filipesbp/hellen88m42bmw/boards/hellen88m42bmw-d/board/hellen88m42bmw-d.png

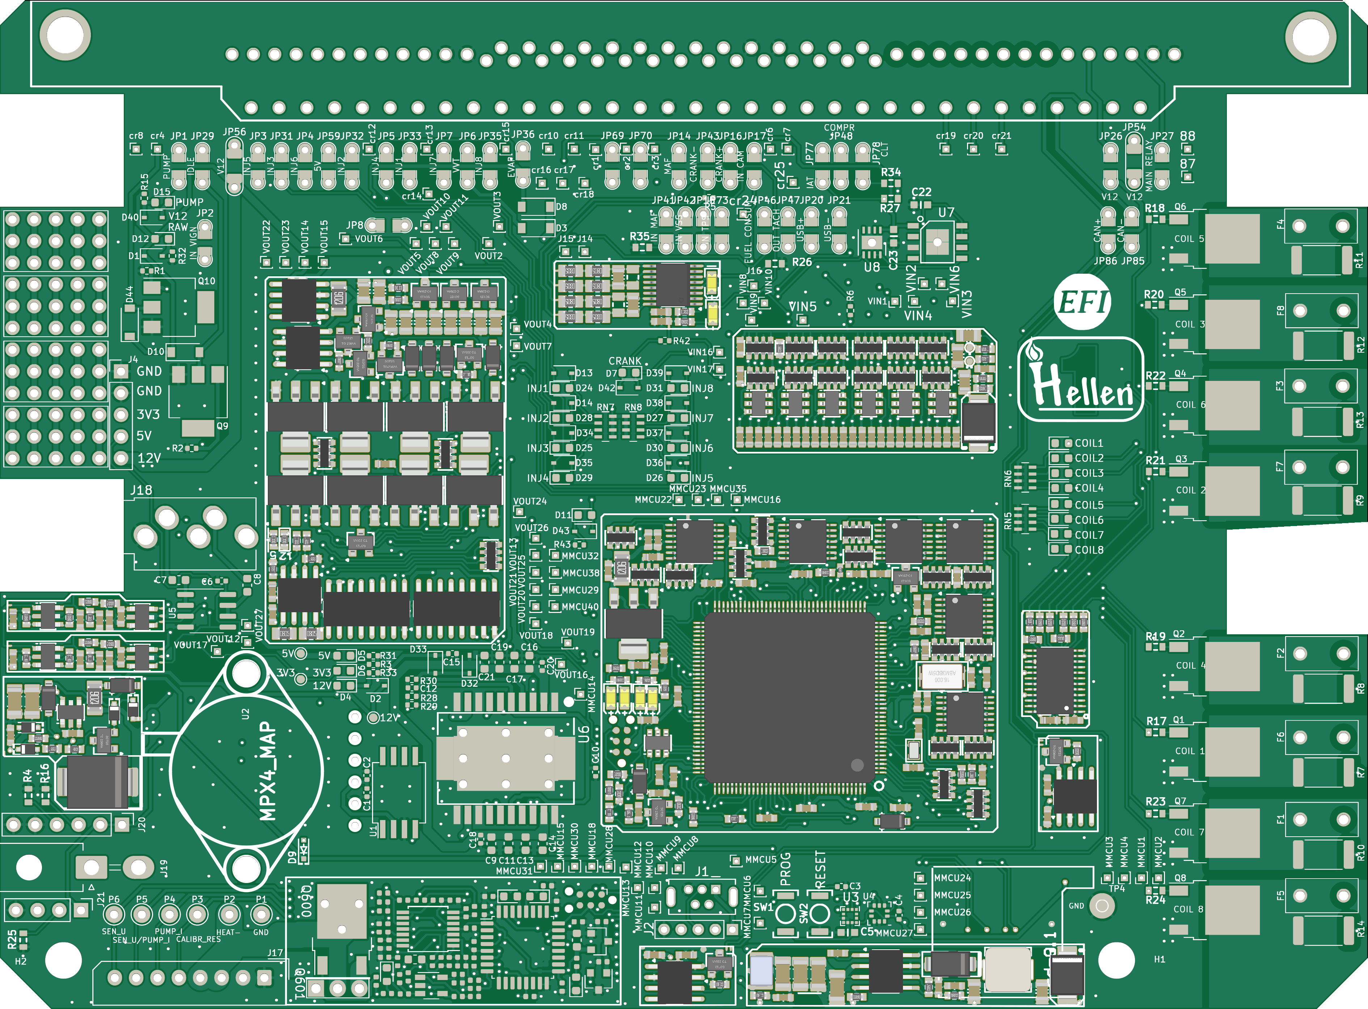
boards/hellen88m42bmw-d/board/hellen88m42bmw-d.png
