filipesbp/hellen88m42bmw/boards/hellen88m42bmw-d/board/misc/hellen88m42bmw-d-outline.png

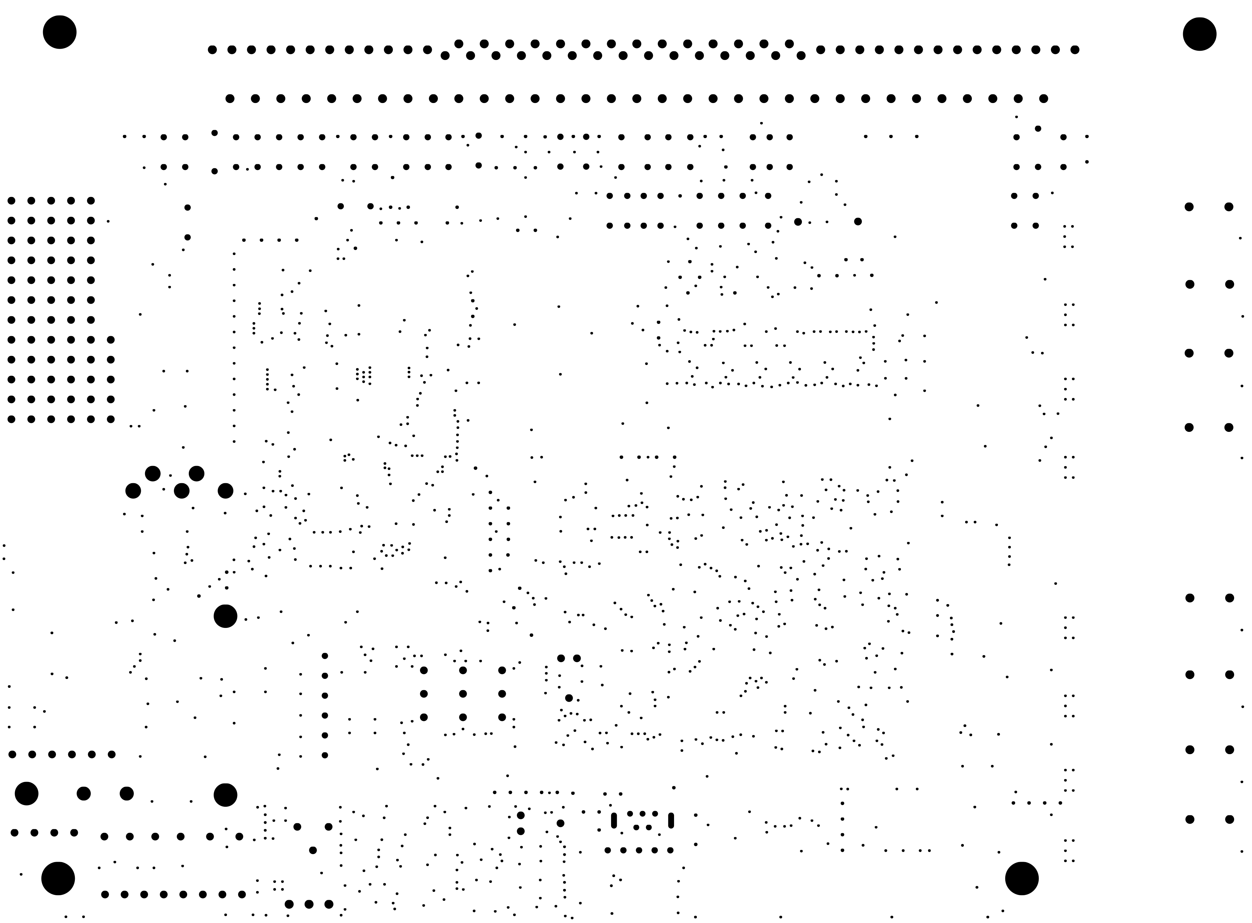
boards/hellen88m42bmw-d/board/misc/hellen88m42bmw-d-outline.png
