filipesbp/hellen88m42bmw/boards/hellen88m42bmw-d/board/misc/hellen88m42bmw-d-top.png

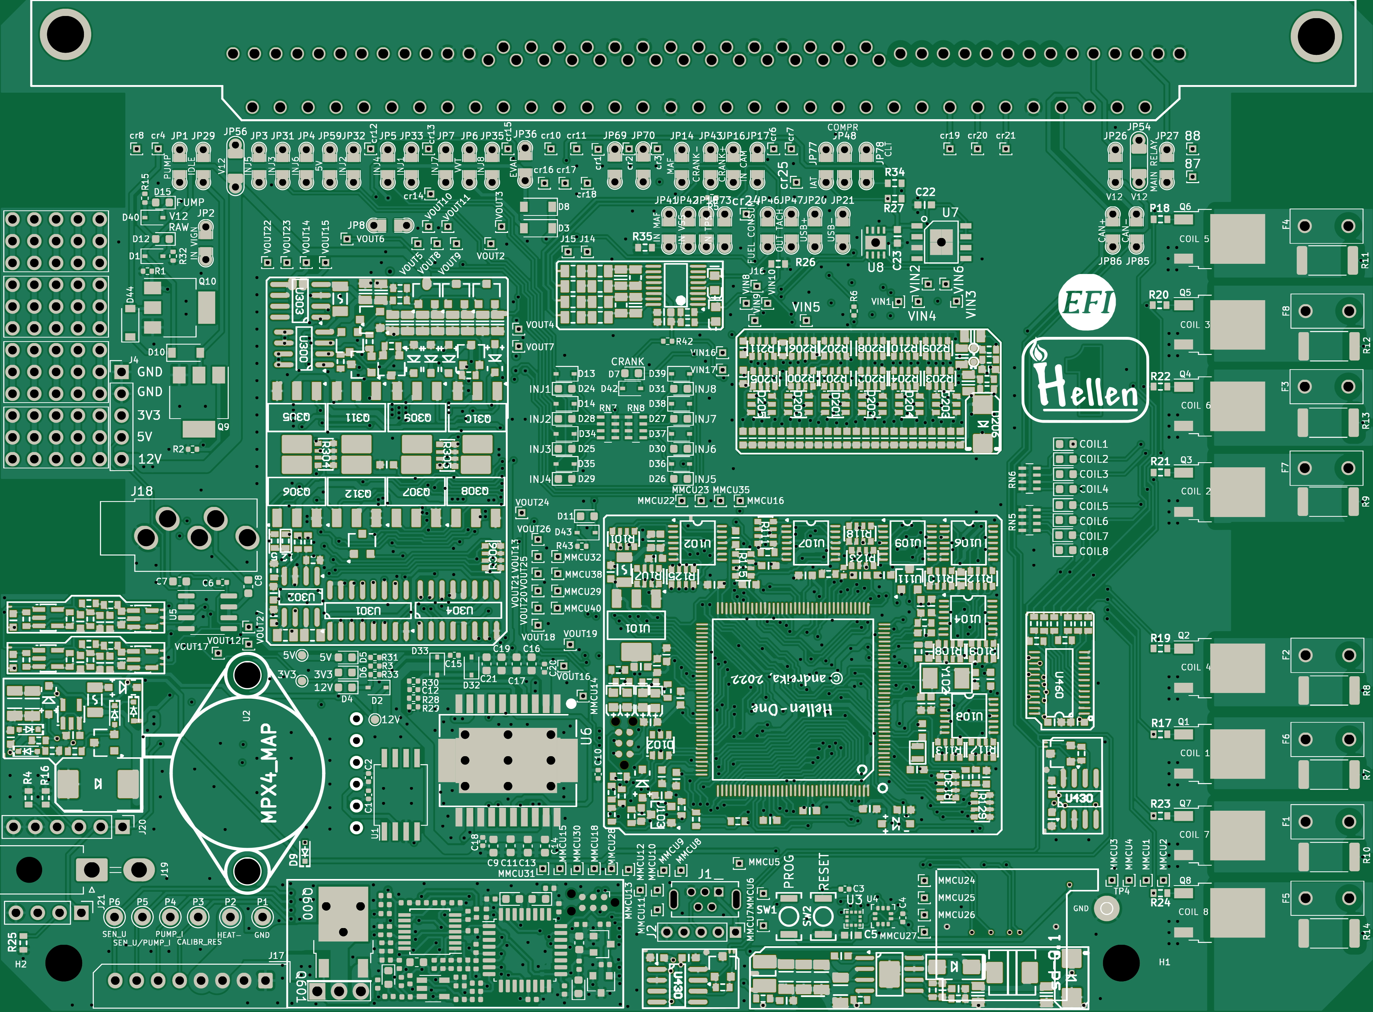
boards/hellen88m42bmw-d/board/misc/hellen88m42bmw-d-top.png
