filipesbp/hellen88m42bmw/gerber/hellen88m42bmw.csv

Comment | Designator | Footprint | LCSC Part #
BATTERY_CR2032 | BT1 | Battery:BatteryHolder_Keystone_1060_1x2032 | C70377
100nF | C1 | Capacitor_SMD:C_0402_1005Metric | C307331
100nF | C2 | Capacitor_SMD:C_0402_1005Metric | C307331
100nF | C3 | Capacitor_SMD:C_0402_1005Metric | C307331
100nF | C4 | Capacitor_SMD:C_0402_1005Metric | C307331
100n | C5 | hellen-one-common:C0603 | C14663
100nF | C6 | Capacitor_SMD:C_0402_1005Metric | C307331
10u | C7 | Capacitor_SMD:C_0603_1608Metric | C96446
10u | C8 | Capacitor_SMD:C_0603_1608Metric | C96446
10u | C9 | Capacitor_SMD:C_0603_1608Metric | C96446
5.6nF | C10 | Capacitor_SMD:C_0402_1005Metric | C115688
10u | C11 | Capacitor_SMD:C_0603_1608Metric | C96446
10nF | C12 | Capacitor_SMD:C_0402_1005Metric | C15195
10u | C13 | Capacitor_SMD:C_0603_1608Metric | C96446
10u | C14 | Capacitor_SMD:C_0603_1608Metric | C96446
220nF | C15 | Capacitor_SMD:C_0402_1005Metric | C16772
10u | C16 | Capacitor_SMD:C_0603_1608Metric | C96446
10u | C17 | Capacitor_SMD:C_0603_1608Metric | C96446
100nF | C18 | Capacitor_SMD:C_0402_1005Metric | C307331
10u | C19 | Capacitor_SMD:C_0603_1608Metric | C96446
100nF | C20 | Capacitor_SMD:C_0402_1005Metric | C307331
10u | C21 | Capacitor_SMD:C_0603_1608Metric | C96446
1u | C22 | hellen-one-common:C0603 | C15849
1u | C23 | hellen-one-common:C0603 | C15849
cr | cr1 | Connector_PinHeader_1.00mm:PinHeader_1x01_P1.00mm_Vertical
cr | cr2 | Connector_PinHeader_1.00mm:PinHeader_1x01_P1.00mm_Vertical
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
MMCU | MMCU31 | Connector_PinHeader_1.00mm:PinHeader_1x01_P1.00mm_Vertical
MMCU | MMCU32 | Connector_PinHeader_1.00mm:PinHeader_1x01_P1.00mm_Vertical
MMCU | MMCU35 | Connector_PinHeader_1.00mm:PinHeader_1x01_P1.00mm_Vertical
MMCU | MMCU38 | Connector_PinHeader_1.00mm:PinHeader_1x01_P1.00mm_Vertical
MMCU | MMCU40 | Connector_PinHeader_1.00mm:PinHeader_1x01_P1.00mm_Vertical
P | P1 | Connector_Pin:Pin_D1.0mm_L10.0mm
P | P2 | Connector_Pin:Pin_D1.0mm_L10.0mm
P | P3 | Connector_Pin:Pin_D1.0mm_L10.0mm
P | P4 | Connector_Pin:Pin_D1.0mm_L10.0mm
P | P5 | Connector_Pin:Pin_D1.0mm_L10.0mm
P | P6 | Connector_Pin:Pin_D1.0mm_L10.0mm
Motronic_88pin | PP1 | rusefi_lib_private:88pin_STS
NGD8201AN | Q1 | Package_TO_SOT_SMD:TO-252-2 | C151649
NGD8201AN | Q2 | Package_TO_SOT_SMD:TO-252-2 | C151649
NGD8201AN | Q3 | Package_TO_SOT_SMD:TO-252-2 | C151649
NGD8201AN | Q4 | Package_TO_SOT_SMD:TO-252-2 | C151649
NGD8201AN | Q5 | Package_TO_SOT_SMD:TO-252-2 | C151649
NGD8201AN | Q6 | Package_TO_SOT_SMD:TO-252-2 | C151649
NGD8201AN | Q7 | Package_TO_SOT_SMD:TO-252-2 | C151649
NGD8201AN | Q8 | Package_TO_SOT_SMD:TO-252-2 | C151649
AUIPS2041LTR | Q9 | Package_TO_SOT_SMD:SOT-223 | C113610
AUIPS2041LTR | Q10 | Package_TO_SOT_SMD:SOT-223 | C113610
10k | R1 | Resistor_SMD:R_0402_1005Metric | C60489
10k | R2 | Resistor_SMD:R_0402_1005Metric | C60489
750R | R3 | Resistor_SMD:R_0402_1005Metric | C25132
680k | R4 | hellen-one-common:R0603 | C25822
DNP | R5 | Resistor_SMD:R_0402_1005Metric
DNP | R6 | Resistor_SMD:R_0402_1005Metric
DNP | R7 | Resistor_SMD:R_2512_6332Metric | NA
DNP | R8 | Resistor_SMD:R_2512_6332Metric | NA
DNP | R9 | Resistor_SMD:R_2512_6332Metric | NA
DNP | R10 | Resistor_SMD:R_2512_6332Metric | NA
DNP | R11 | Resistor_SMD:R_2512_6332Metric | NA
DNP | R12 | Resistor_SMD:R_2512_6332Metric | NA
DNP | R13 | Resistor_SMD:R_2512_6332Metric | NA
DNP | R14 | Resistor_SMD:R_2512_6332Metric | NA
20k | R15 | Resistor_SMD:R_0402_1005Metric | C25765
680k | R16 | hellen-one-common:R0603 | C25822
22 | R17 | hellen-one-common:R0603 | C23345
22 | R18 | hellen-one-common:R0603 | C23345
22 | R19 | hellen-one-common:R0603 | C23345
22 | R20 | hellen-one-common:R0603 | C23345
22 | R21 | hellen-one-common:R0603 | C23345
22 | R22 | hellen-one-common:R0603 | C23345
22 | R23 | hellen-one-common:R0603 | C23345
22 | R24 | hellen-one-common:R0603 | C23345
680k | R25 | hellen-one-common:R0603 | C25822
DNP | R26 | hellen-one-common:R0603
2.7k | R27 | hellen-one-common:R0603 | C13167
100k | R28 | Resistor_SMD:R_0402_1005Metric | C106234
10k | R29 | Resistor_SMD:R_0402_1005Metric | C60489
100 | R30 | Resistor_SMD:R_0402_1005Metric | C106233
1k6 | R31 | Resistor_SMD:R_0402_1005Metric | C25931
5k1 | R32 | Resistor_SMD:R_0402_1005Metric | C25941
5k1 | R33 | Resistor_SMD:R_0402_1005Metric | C25941
2.7k | R34 | hellen-one-common:R0603 | C13167
DNP | R35 | hellen-one-common:R0603
4.7k | R42 | Resistor_SMD:R_0402_1005Metric | C25940
5k1 | R43 | Resistor_SMD:R_0402_1005Metric | C25941
1k | RN5 | Resistor_SMD:R_Array_Concave_4x0603 | C240722
1k | RN6 | Resistor_SMD:R_Array_Concave_4x0603 | C240722
4.7k | RN7 | Resistor_SMD:R_Array_Concave_4x0603 | C1980
4.7k | RN8 | Resistor_SMD:R_Array_Concave_4x0603 | C1980
Button_SPST | SW1 | hellen-one-common:SMD-2_2.9x3.9x1.7 | C115357
Button_SPST | SW2 | hellen-one-common:SMD-2_2.9x3.9x1.7 | C115357
TestPoint | TP1 | TestPoint:TestPoint_Pad_D1.0mm
TestPoint | TP2 | TestPoint:TestPoint_Pad_D1.0mm
TestPoint | TP3 | TestPoint:TestPoint_Pad_D1.0mm
TestPoint | TP4 | TestPoint:TestPoint_Pad_D1.0mm
MPXA6115A | U1 | Package_SO:SSO-8_6.8x5.9mm_P1.27mm_Clearance7mm
MPX4_MAP | U2 | rusefi_lib:MPX-4_MAP
LIS2DW12TR | U3 | hellen-one-common:LGA-12_2x2mm_P0.5mm | C189624
LPS25HB | U4 | Package_LGA:ST_HLGA-10_2.5x2.5mm_P0.6mm_LayoutBorder3x2y | C87898
MCP6002-xSN | U5 | Package_SO:SOIC-8_3.9x4.9mm_P1.27mm | C7377
L6205PD | U6 | hellen-one-common:SO20POWER | C36543
TLS115_SOIC | U7 | hellen-one-common:PG-DSO-8-43 | C540242
TLS115_SON | U8 | Package_SON:HVSON-8-1EP_3x3mm_P0.65mm_EP1.6x2.4mm
VIN8 | VIN1 | Connector_PinHeader_1.00mm:PinHeader_1x01_P1.00mm_Vertical
VIN8 | VIN2 | Connector_PinHeader_1.00mm:PinHeader_1x01_P1.00mm_Vertical
VIN8 | VIN3 | Connector_PinHeader_1.00mm:PinHeader_1x01_P1.00mm_Vertical
VIN8 | VIN4 | Connector_PinHeader_1.00mm:PinHeader_1x01_P1.00mm_Vertical
VIN8 | VIN5 | Connector_PinHeader_1.00mm:PinHeader_1x01_P1.00mm_Vertical
VIN8 | VIN6 | Connector_PinHeader_1.00mm:PinHeader_1x01_P1.00mm_Vertical
VIN8 | VIN8 | Connector_PinHeader_1.00mm:PinHeader_1x01_P1.00mm_Vertical
VIN9 | VIN9 | Connector_PinHeader_1.00mm:PinHeader_1x01_P1.00mm_Vertical
VIN10 | VIN10 | Connector_PinHeader_1.00mm:PinHeader_1x01_P1.00mm_Vertical
VIN16 | VIN16 | Connector_PinHeader_1.00mm:PinHeader_1x01_P1.00mm_Vertical
VIN17 | VIN17 | Connector_PinHeader_1.00mm:PinHeader_1x01_P1.00mm_Vertical
VOUT4 | VOUT2 | Connector_PinHeader_1.00mm:PinHeader_1x01_P1.00mm_Vertical
VOUT4 | VOUT3 | Connector_PinHeader_1.00mm:PinHeader_1x01_P1.00mm_Vertical
VOUT4 | VOUT4 | Connector_PinHeader_1.00mm:PinHeader_1x01_P1.00mm_Vertical
VOUT5 | VOUT5 | Connector_PinHeader_1.00mm:PinHeader_1x01_P1.00mm_Vertical
VOUT6 | VOUT6 | Connector_PinHeader_1.00mm:PinHeader_1x01_P1.00mm_Vertical
VOUT4 | VOUT7 | Connector_PinHeader_1.00mm:PinHeader_1x01_P1.00mm_Vertical
VOUT4 | VOUT8 | Connector_PinHeader_1.00mm:PinHeader_1x01_P1.00mm_Vertical
VOUT4 | VOUT9 | Connector_PinHeader_1.00mm:PinHeader_1x01_P1.00mm_Vertical
VOUT4 | VOUT10 | Connector_PinHeader_1.00mm:PinHeader_1x01_P1.00mm_Vertical
VOUT4 | VOUT11 | Connector_PinHeader_1.00mm:PinHeader_1x01_P1.00mm_Vertical
VOUT4 | VOUT12 | Connector_PinHeader_1.00mm:PinHeader_1x01_P1.00mm_Vertical
VOUT4 | VOUT13 | Connector_PinHeader_1.00mm:PinHeader_1x01_P1.00mm_Vertical
VOUT4 | VOUT14 | Connector_PinHeader_1.00mm:PinHeader_1x01_P1.00mm_Vertical
VOUT4 | VOUT15 | Connector_PinHeader_1.00mm:PinHeader_1x01_P1.00mm_Vertical
VOUT4 | VOUT16 | Connector_PinHeader_1.00mm:PinHeader_1x01_P1.00mm_Vertical
VOUT4 | VOUT17 | Connector_PinHeader_1.00mm:PinHeader_1x01_P1.00mm_Vertical
VOUT4 | VOUT18 | Connector_PinHeader_1.00mm:PinHeader_1x01_P1.00mm_Vertical
VOUT4 | VOUT19 | Connector_PinHeader_1.00mm:PinHeader_1x01_P1.00mm_Vertical
VOUT4 | VOUT20 | Connector_PinHeader_1.00mm:PinHeader_1x01_P1.00mm_Vertical
VOUT4 | VOUT21 | Connector_PinHeader_1.00mm:PinHeader_1x01_P1.00mm_Vertical
VOUT4 | VOUT22 | Connector_PinHeader_1.00mm:PinHeader_1x01_P1.00mm_Vertical
VOUT4 | VOUT23 | Connector_PinHeader_1.00mm:PinHeader_1x01_P1.00mm_Vertical
VOUT4 | VOUT24 | Connector_PinHeader_1.00mm:PinHeader_1x01_P1.00mm_Vertical
VOUT4 | VOUT25 | Connector_PinHeader_1.00mm:PinHeader_1x01_P1.00mm_Vertical
VOUT4 | VOUT26 | Connector_PinHeader_1.00mm:PinHeader_1x01_P1.00mm_Vertical
VOUT4 | VOUT27 | Connector_PinHeader_1.00mm:PinHeader_1x01_P1.00mm_Vertical
