filipesbp/hellen88m42bmw/boards/hellen88m42bmw-d/frame/88m42bmw-schematic.pdf

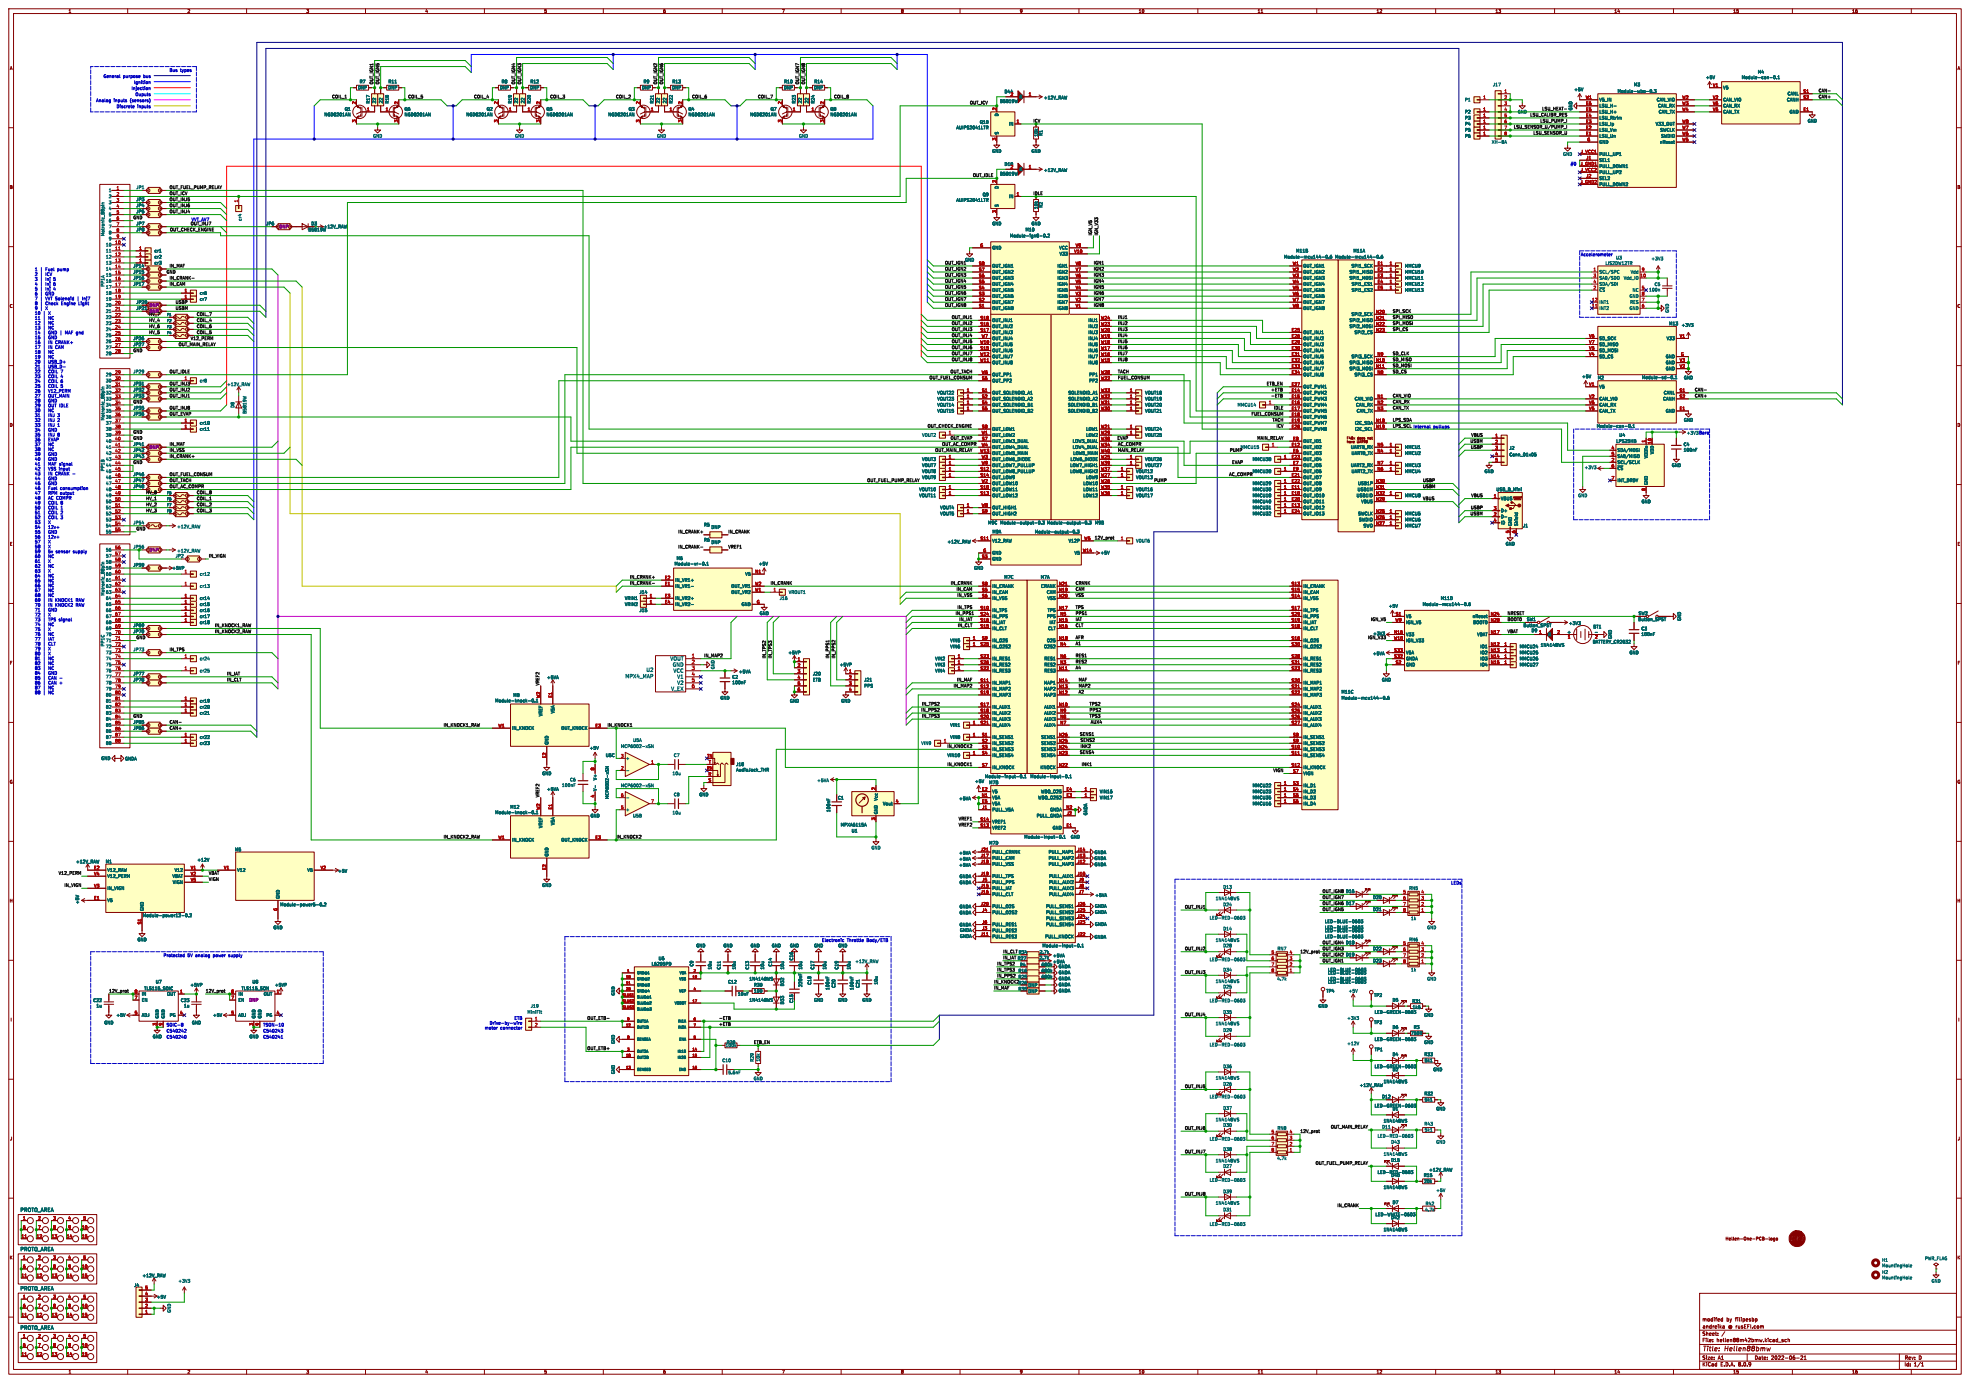
[picture p5: page 1]

39 | GND
40 | GND
41 | MAF signal 42 | VSS input 43 | IN CRANK - 44 | GND

45 | GND
46 | Fuel consumption
47 | RPM output 48 | AC COMPR

S11 GND
V12_RAW
N19 VSS N20 CRANK N21 KNOCK N22 SENS4 N23 SENS3 N24 SENS2 N25 SENS1 N26 RES2 N3 O2S2 N4 PPS N5 RES1 N6 AUX4 N7 AUX3 N8 AUX2 N9 M7A Module-input-0.1 GND

IAT N15 CLT N16 TPS N17 O2S N18 CAM

8 GND M12 Module-knock-0.1 V5A E1 GND E2 OUT_KNOCK E3 IN_KNOCK W1 VREF W2 GND

ETB Drive-by-wire motor connector

File: hellen88m42bmw.kicad_sch Sheet: / andreika @ rusEFI.com
