filipesbp/hellen88m42bmw/hellen88m42bmw.kicad_sch

## KiCad design hellen88m42bmw.kicad_sch (2025-03-13)

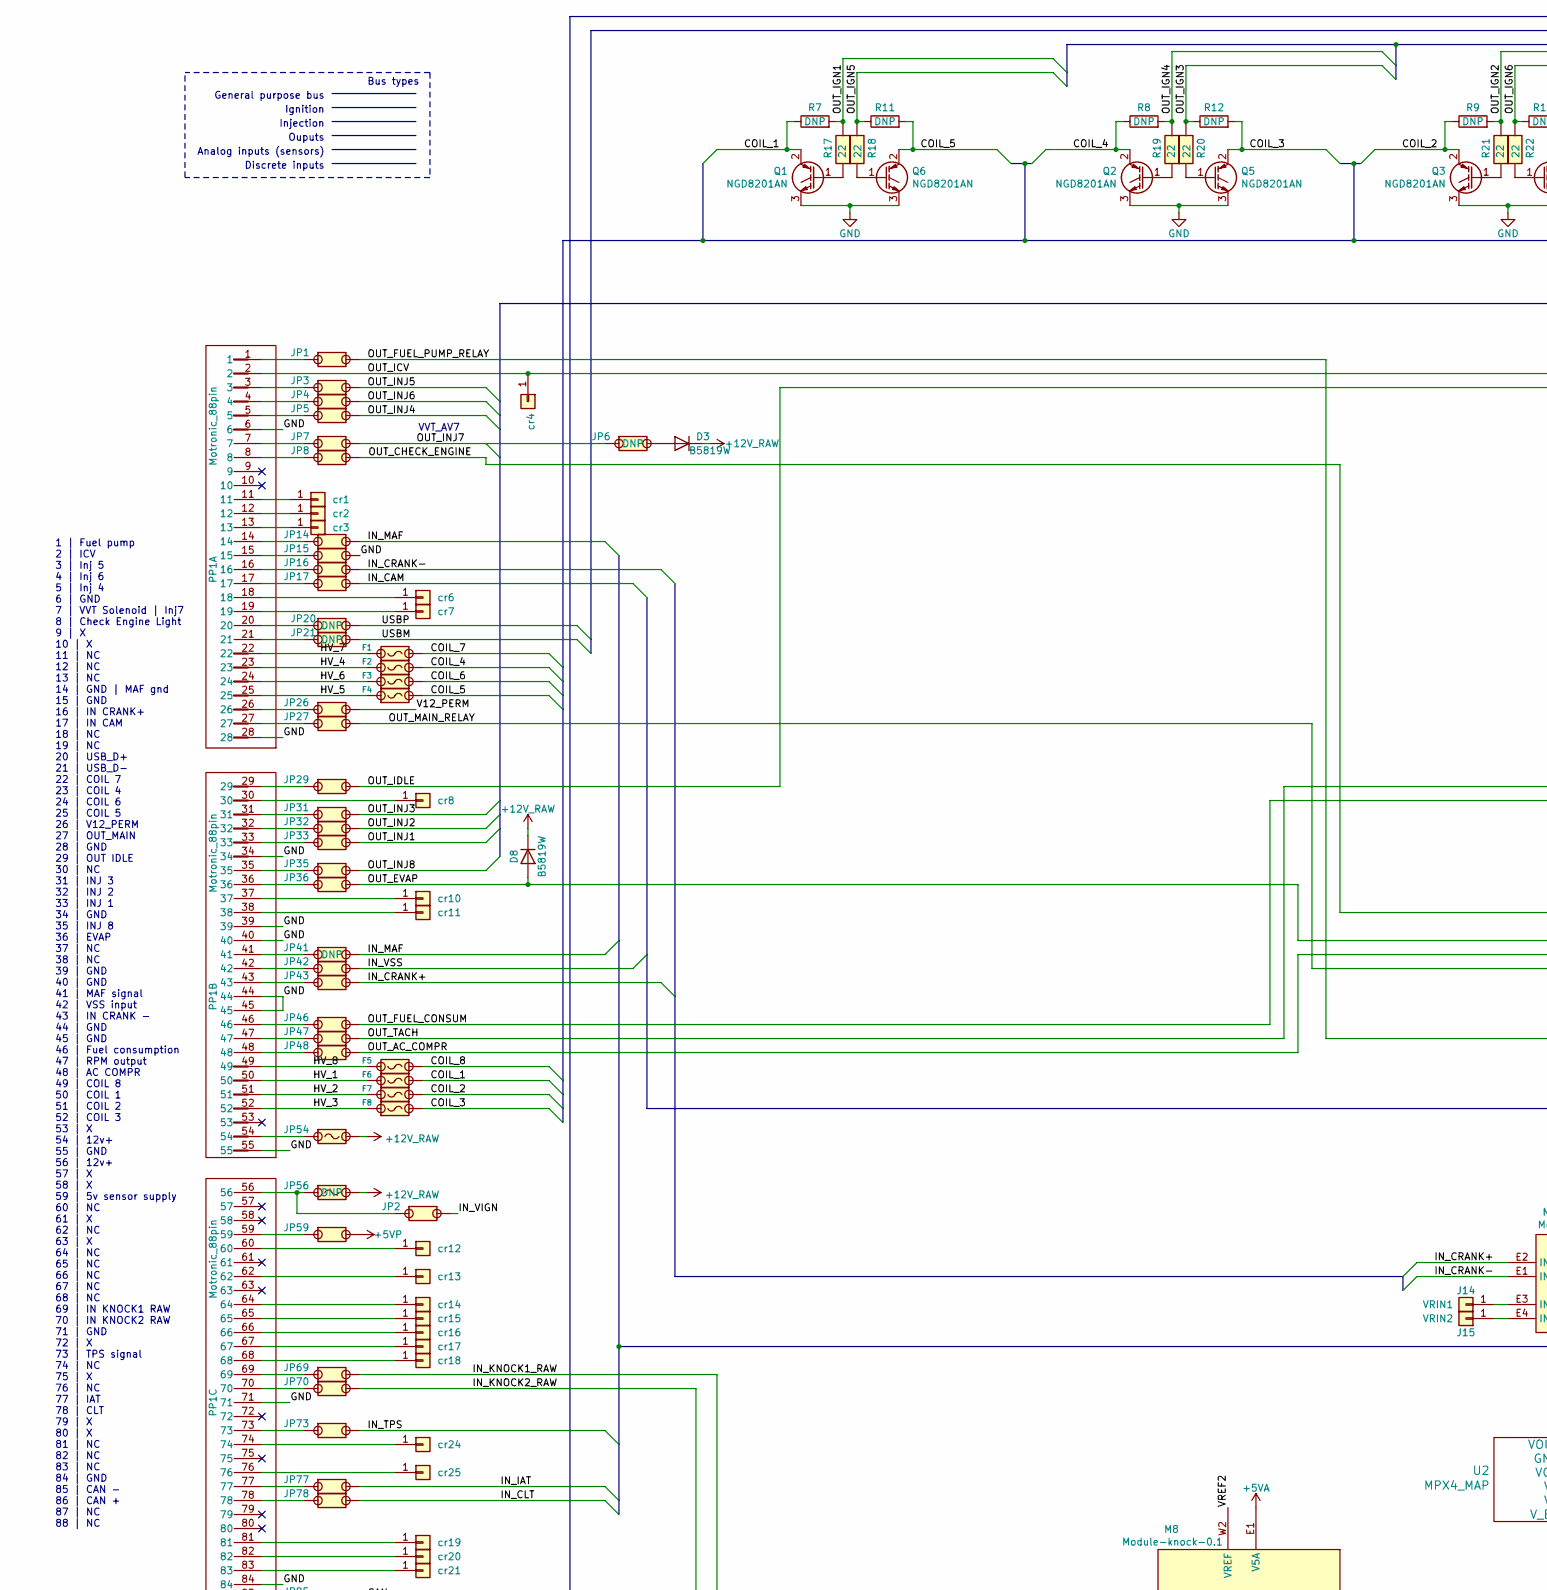
[picture p17: schematic hellen88m42bmw.kicad_sch, part in row 1, column 1]

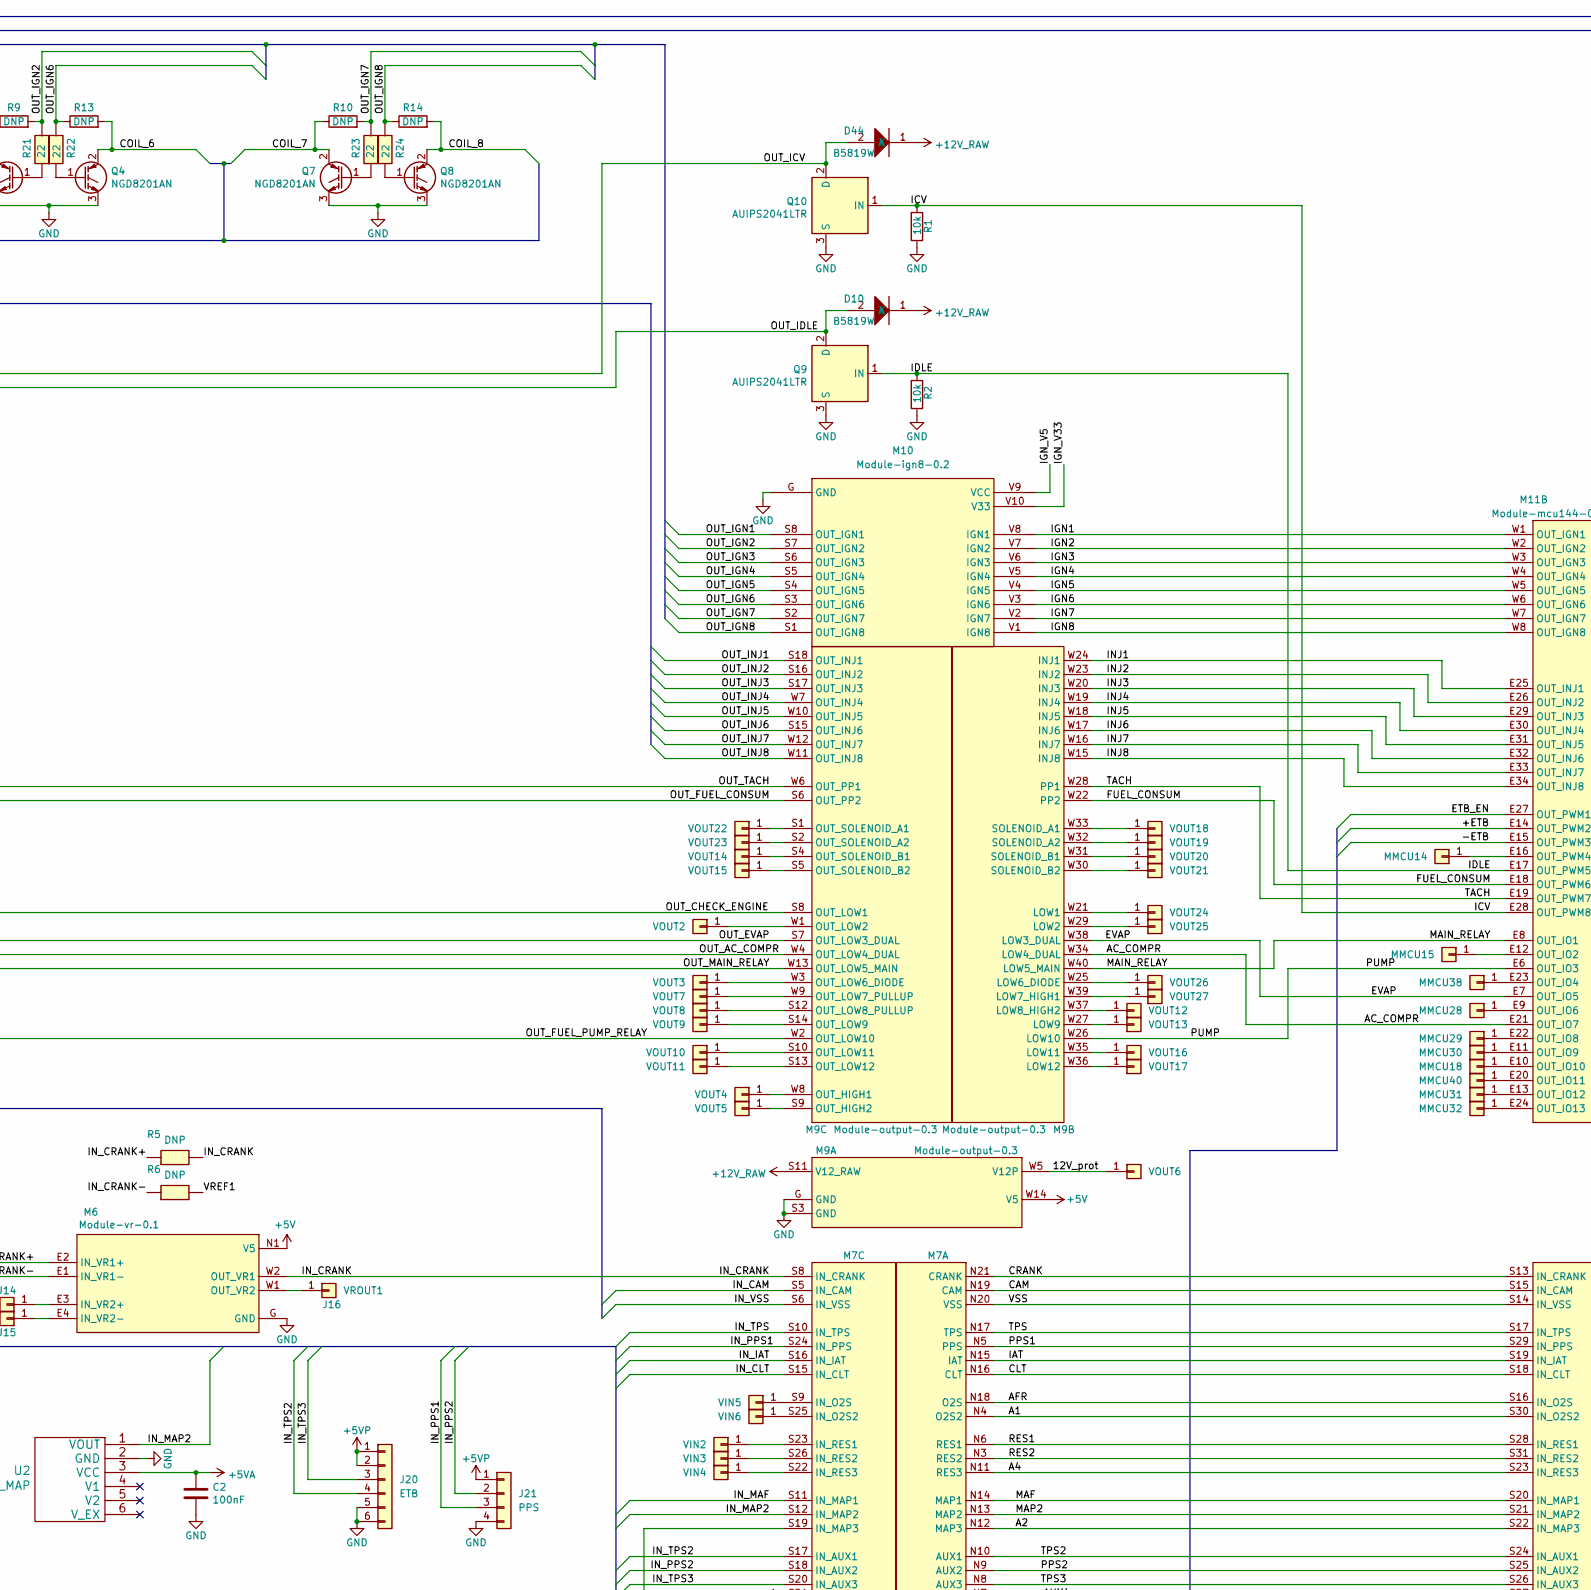
[picture p18: schematic hellen88m42bmw.kicad_sch, part in row 1, column 2]

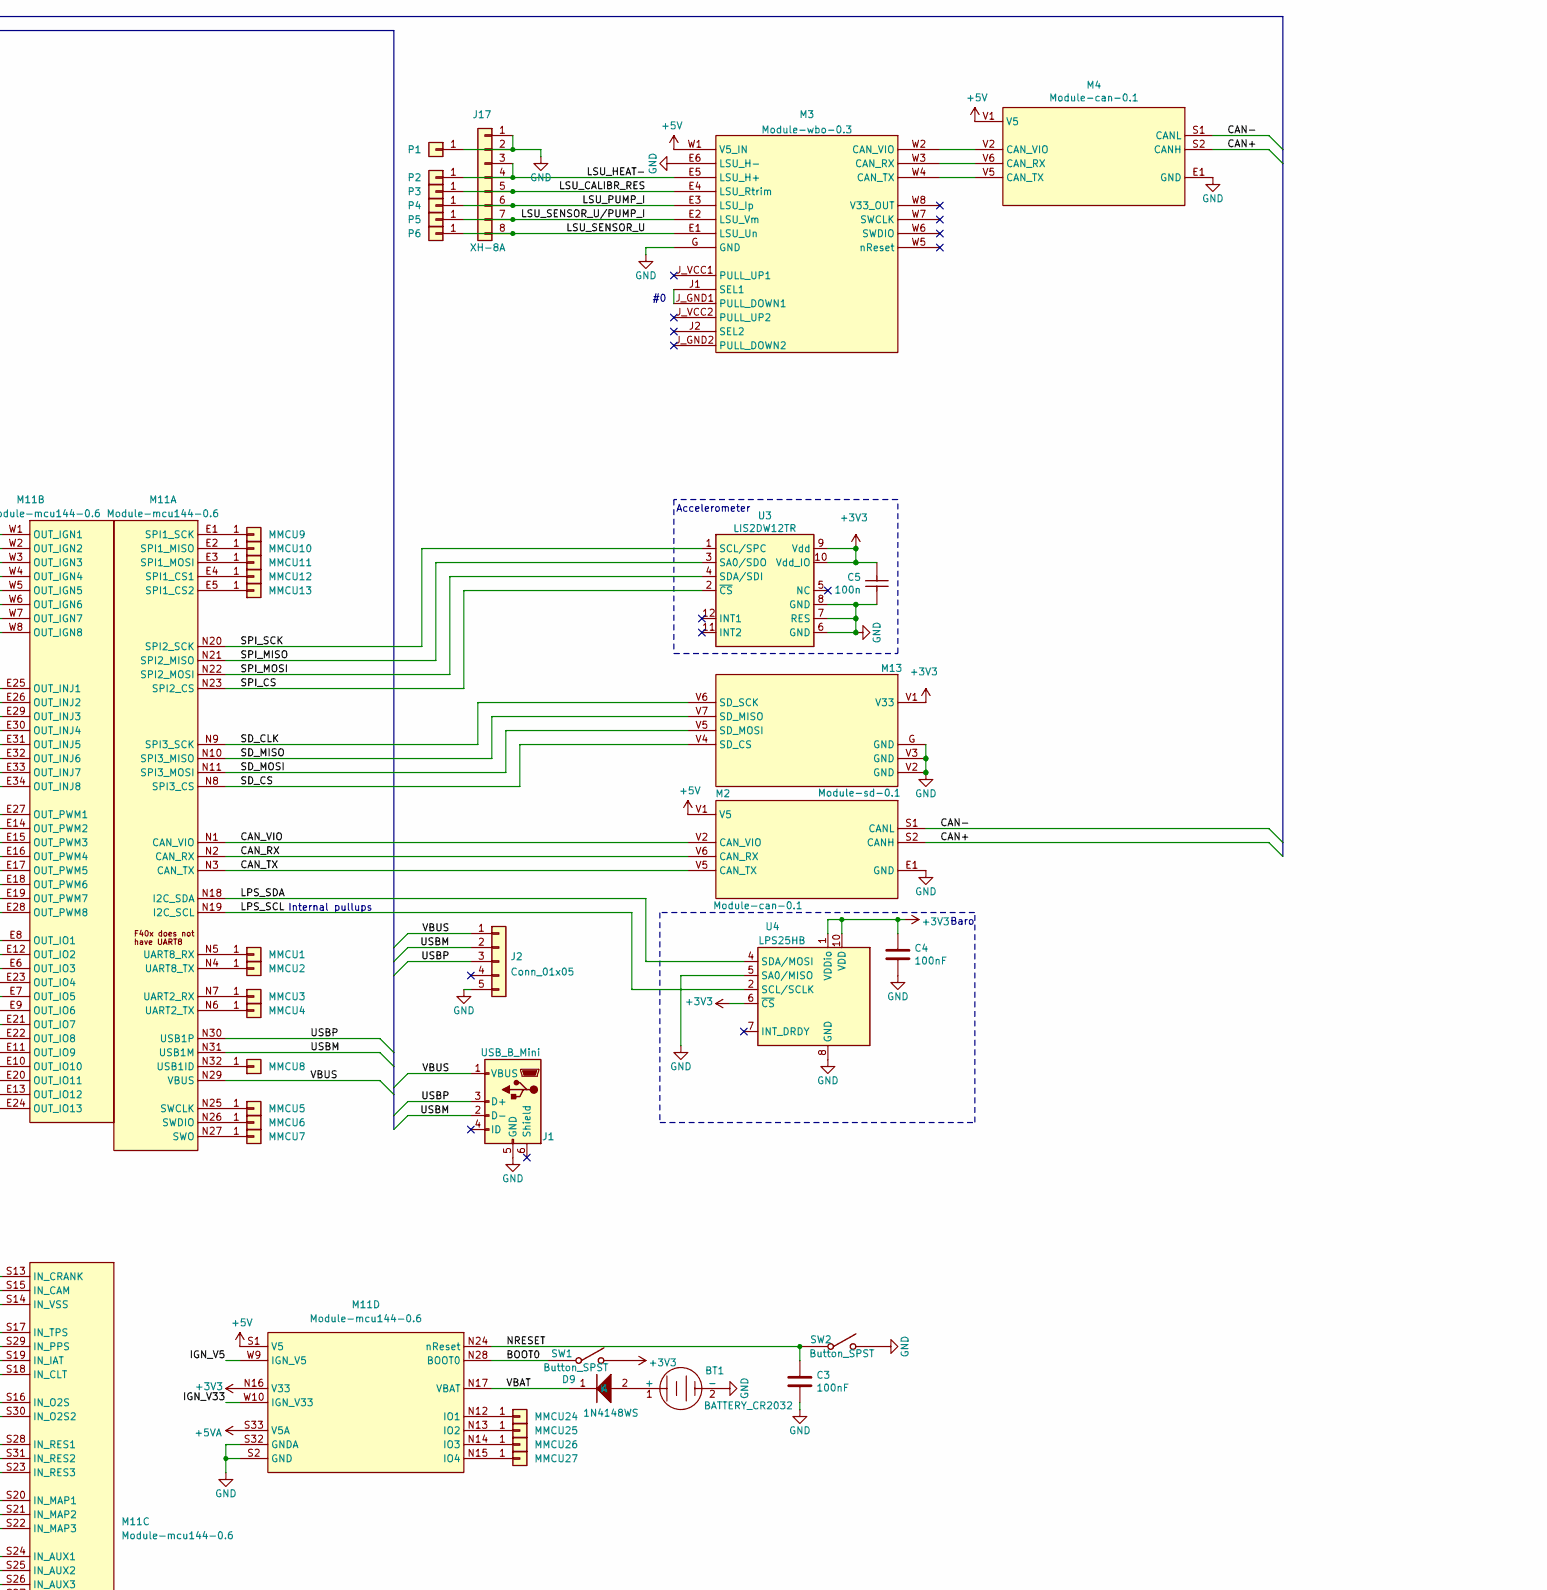
[picture p19: schematic hellen88m42bmw.kicad_sch, part in row 1, column 3]

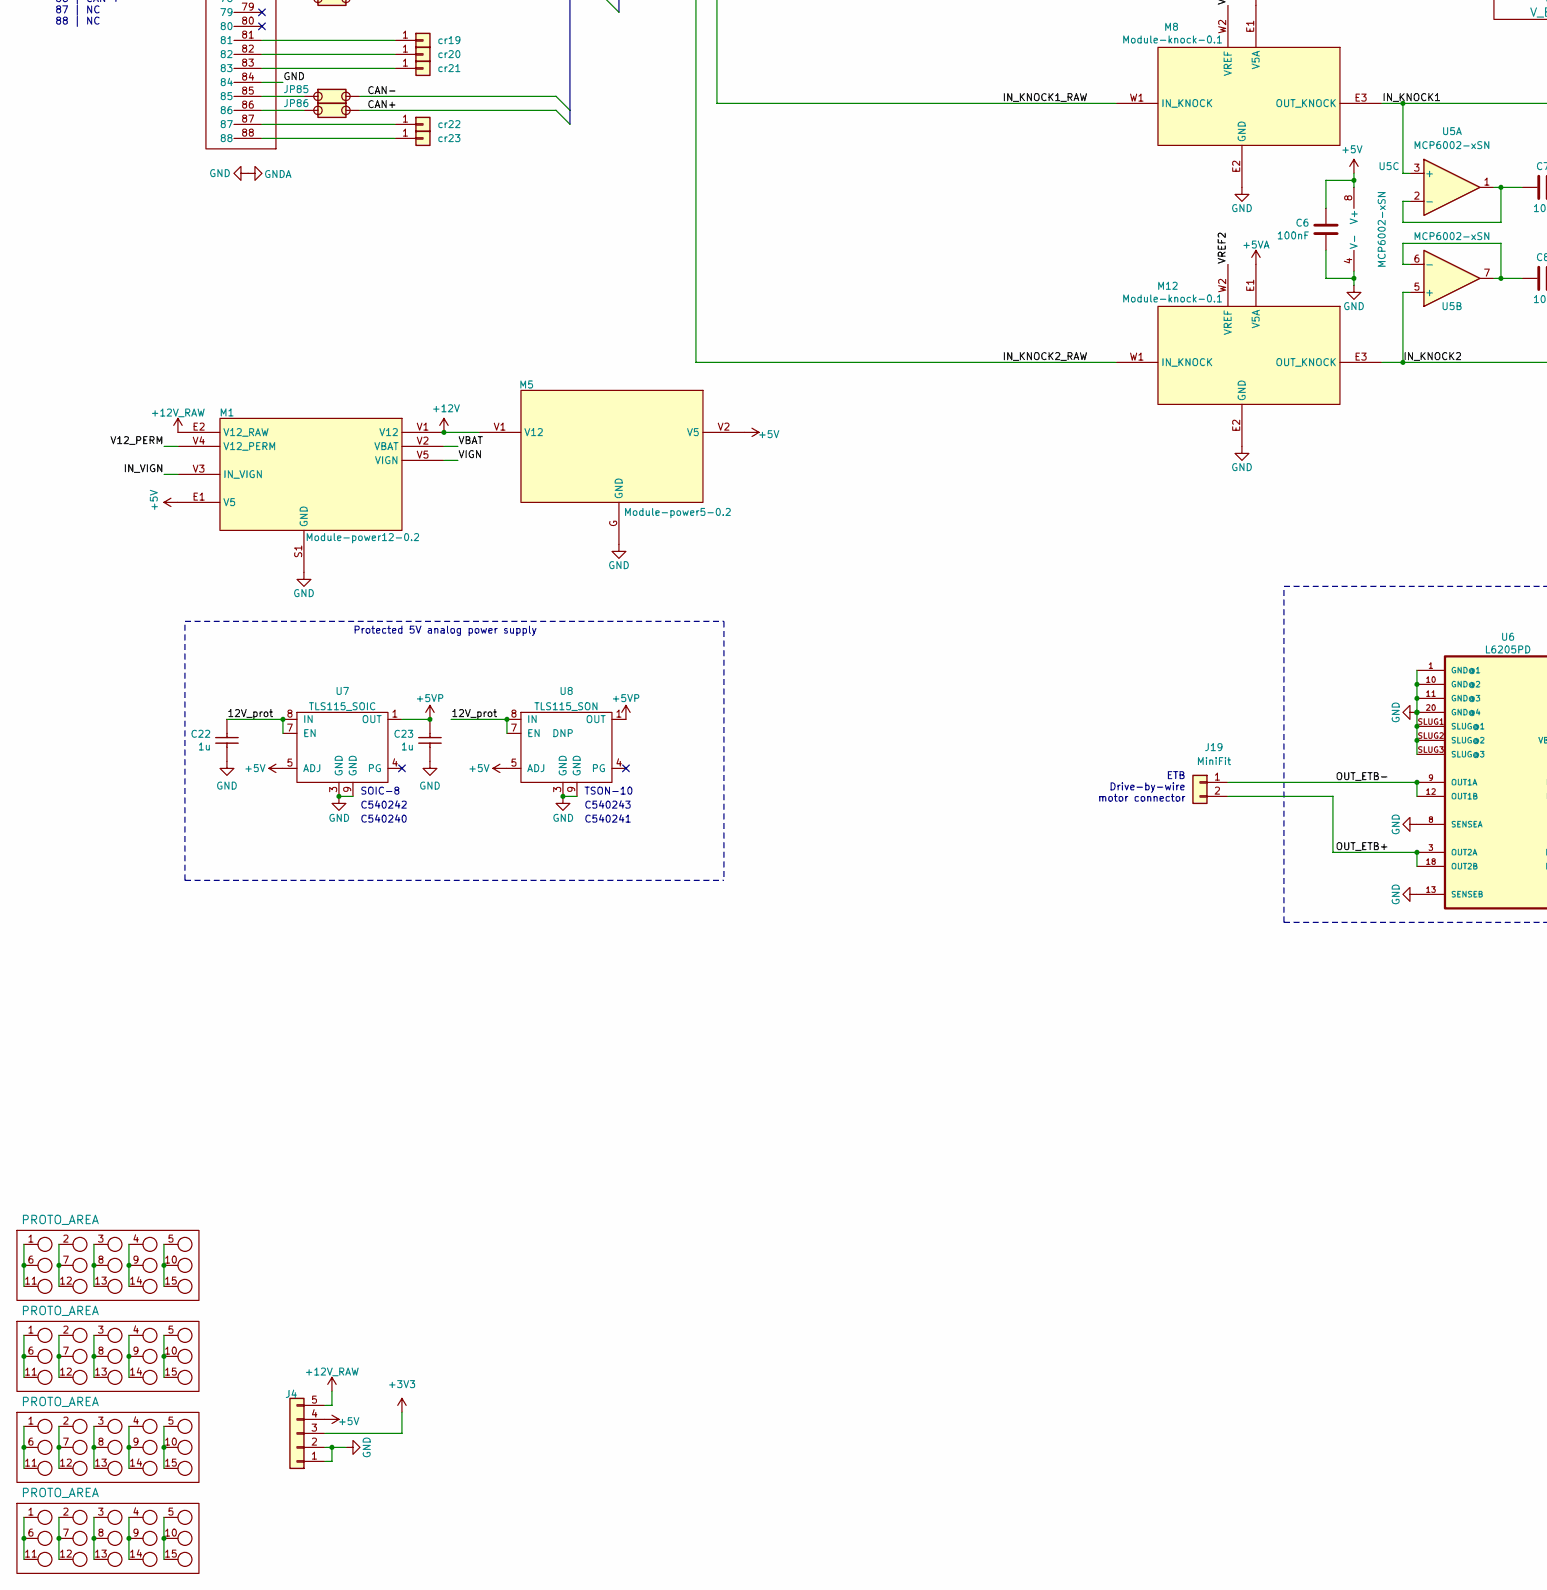
[picture p20: schematic hellen88m42bmw.kicad_sch, part in row 2, column 1]

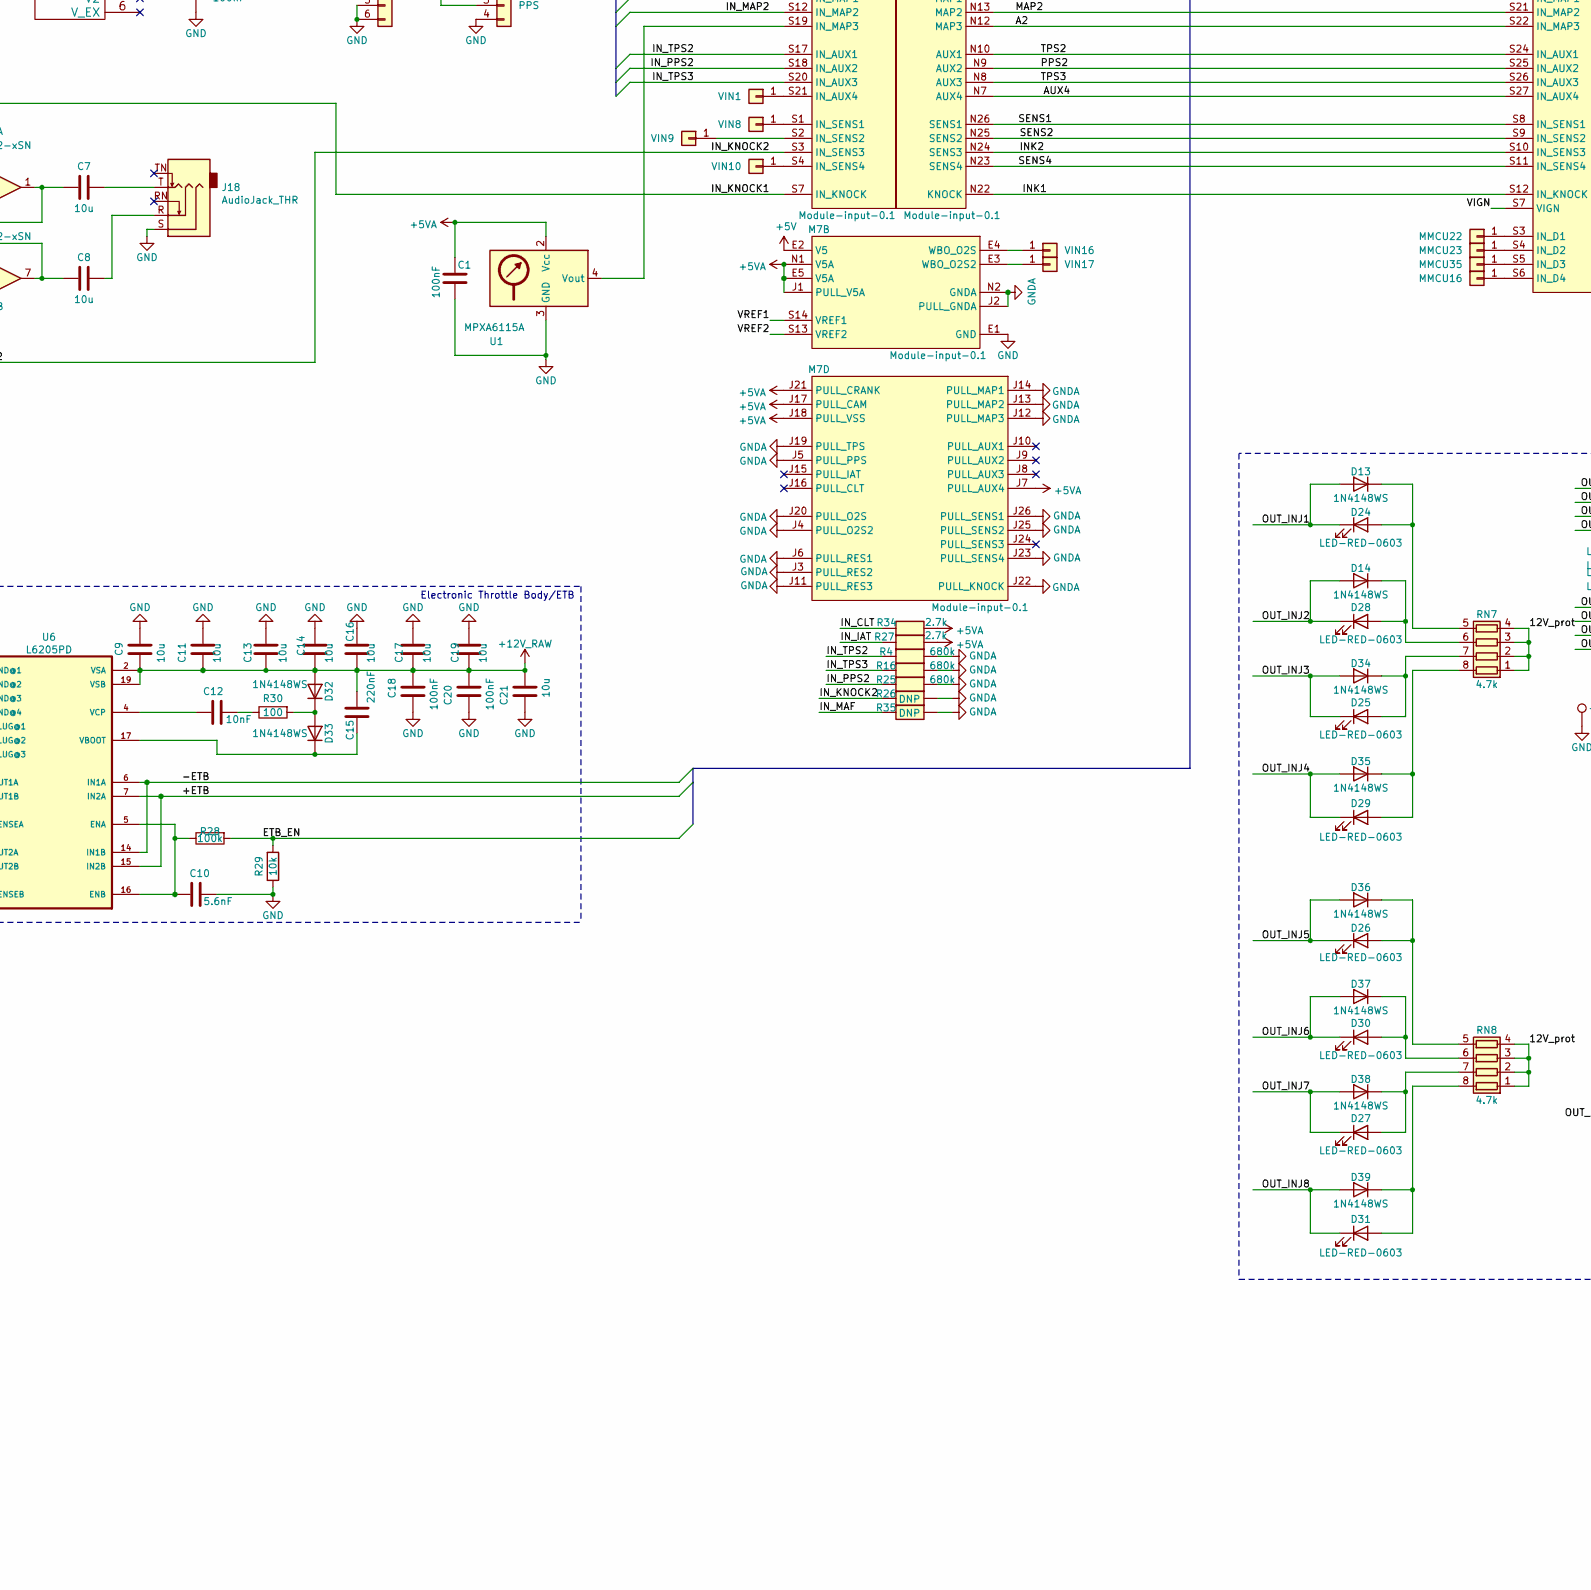
[picture p21: schematic hellen88m42bmw.kicad_sch, part in row 2, column 2]

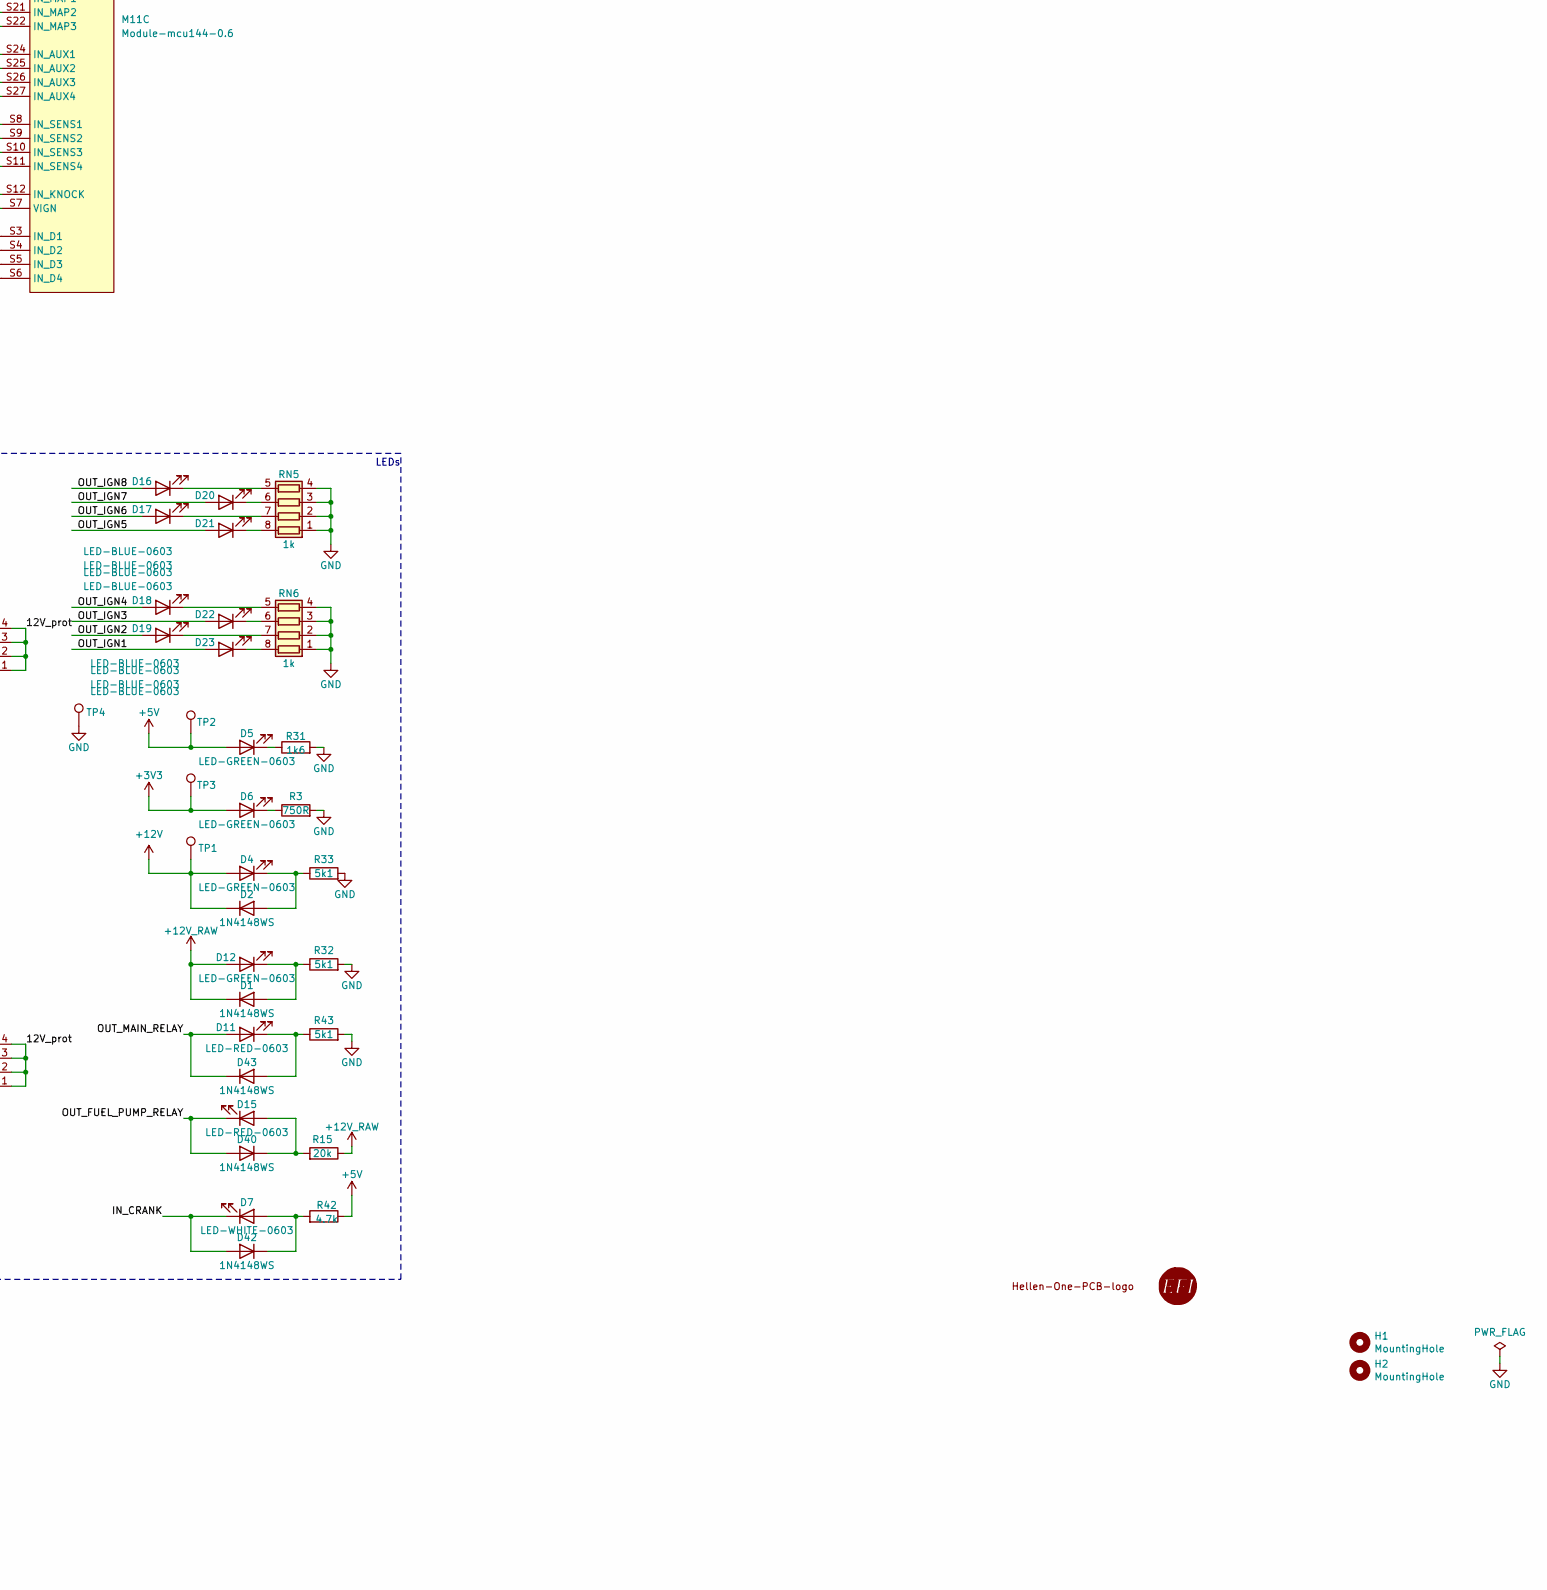
[picture p22: schematic hellen88m42bmw.kicad_sch, part in row 2, column 3]

Parts:
BT1: BATTERY_CR2032; BatteryHolder_Keystone_1060_1x2032; LCSC C70377
C1, C2, C3, C4, C6, C18, C20: 100nF; C_0402_1005Metric; LCSC C307331
C5: 100n; C0603; LCSC C14663
C7, C8, C9, C11, C13, C14, C16, C17, C19, C21: 10u; C_0603_1608Metric; LCSC C96446
C10: 5.6nF; C_0402_1005Metric; LCSC C115688
C12: 10nF; C_0402_1005Metric; LCSC C15195
C15: 220nF; C_0402_1005Metric; LCSC C16772
C22, C23: 1u; C0603; LCSC C15849
D1, D2, D13, D14, D32, D33, D34, D35, D36, D37, D38, D39, D40, D42, D43: 1N4148WS; D_SOD-323; LCSC C2128
D3, D8, D10, D44: B5819W; D_SOD-123; LCSC C8598
D4, D5, D6, D12: LED-GREEN-0603; LED_0603_1608Metric; LCSC C72043
D7: LED-WHITE-0603; LED_0603_1608Metric; LCSC C84265
D9: 1N4148WS; SOD-323; LCSC C2128
D11, D15, D24, D25, D26, D27, D28, D29, D30, D31: LED-RED-0603; LED_0603_1608Metric; LCSC C2286
D16, D17, D18, D19, D20, D21, D22, D23: LED-BLUE-0603; LED_0603_1608Metric; LCSC C72041
F1, F2, F3, F4, F5, F6, F7, F8: 10A; 36911600000; LCSC C354908
G1, G2: LOGO
G3, G4, G6, G7: PROTO_AREA
H1, H2: MountingHole; MountingHole_4.3mm_M4_DIN965
J1: USB_B_Mini; USB-MINI-B-VERTICAL; LCSC C13453
J2: Conn_01x05; PinHeader_1x05_P2.00mm_Vertical
J4: Conn_01x05; PinHeader_1x05_P2.54mm_Vertical
J14: VRIN1; PinHeader_1x01_P1.00mm_Vertical
J15: VRIN2; PinHeader_1x01_P1.00mm_Vertical
J16: VROUT1; PinHeader_1x01_P1.00mm_Vertical
J17: XH-8A; LCSC C10385
J18: AudioJack_THR; Jack_3.5mm_PJ-3250-5A; LCSC C165947
J19: MiniFit; Molex_Mini-Fit_Jr_5569-02A2_2x01_P4.20mm_Horizontal
J20: ETB; PinHeader_1x06_P2.54mm_Vertical
J21: PPS; PinHeader_1x04_P2.54mm_Vertical
JP1, JP2, JP3, JP4, JP5, JP7, JP8, JP14, JP15, JP16, JP17, JP26, JP27, JP29, JP31, JP32, JP33, JP35, JP36, JP42, JP43, JP46, JP47, JP48, JP59, JP69, JP70, JP73, JP77, JP78, JP85, JP86: Jumper_2_Open; PAD-0805-PAD; LCSC C17477
JP6, JP20, JP21, JP41: Jumper_2_Open; PAD-0805-PAD
JP54: Jumper_2_Open; PAD-1206-PAD; LCSC C182446
JP56: Jumper_2_Open; PAD-1206-PAD
M1: Module-power12-0.2; power12
M2, M4: Module-can-0.1; can
M3: Module-wbo-0.3; wbo
M5: Module-power5-0.2; power5
M6: Module-vr-0.1; vr
M7: Module-input-0.1; input
M8, M12: Module-knock-0.1; knock
M9: Module-output-0.3; output
M10: Module-ign8-0.2; ign8
M11: Module-mcu144-0.6; mcu
M13: Module-sd-0.1; sd
MMCU1, MMCU2, MMCU3, MMCU4, MMCU5, MMCU6, MMCU7, MMCU8, MMCU9, MMCU10, MMCU11, MMCU12, MMCU13, MMCU14, MMCU15, MMCU16, MMCU18, MMCU22, MMCU23, MMCU24, MMCU25, MMCU26, MMCU27, MMCU28, MMCU29, MMCU30, MMCU31, MMCU32, MMCU35, MMCU38, MMCU40: MMCU; PinHeader_1x01_P1.00mm_Vertical
P1, P2, P3, P4, P5, P6: P; Pin_D1.0mm_L10.0mm
PP1: Motronic_88pin; 88pin_STS
Q1, Q2, Q3, Q4, Q5, Q6, Q7, Q8: NGD8201AN; TO-252-2; LCSC C151649
Q9, Q10: AUIPS2041LTR; SOT-223; LCSC C113610
R1, R2, R29: 10k; R_0402_1005Metric; LCSC C60489
R3: 750R; R_0402_1005Metric; LCSC C25132
R4, R16, R25: 680k; R0603; LCSC C25822
R5, R6: DNP; R_0402_1005Metric
R7, R8, R9, R10, R11, R12, R13, R14: DNP; R_2512_6332Metric; LCSC NA
R15: 20k; R_0402_1005Metric; LCSC C25765
R17, R18, R19, R20, R21, R22, R23, R24: 22; R0603; LCSC C23345
R26, R35: DNP; R0603
R27, R34: 2.7k; R0603; LCSC C13167
R28: 100k; R_0402_1005Metric; LCSC C106234
R30: 100; R_0402_1005Metric; LCSC C106233
R31: 1k6; R_0402_1005Metric; LCSC C25931
R32, R33, R43: 5k1; R_0402_1005Metric; LCSC C25941
R42: 4.7k; R_0402_1005Metric; LCSC C25940
RN5, RN6: 1k; R_Array_Concave_4x0603; LCSC C240722
RN7, RN8: 4.7k; R_Array_Concave_4x0603; LCSC C1980
SW1, SW2: Button_SPST; SMD-2_2.9x3.9x1.7; LCSC C115357
TP1, TP2, TP3, TP4: TestPoint; TestPoint_Pad_D1.0mm
U1: MPXA6115A; SSO-8_6.8x5.9mm_P1.27mm_Clearance7mm
U2: MPX4_MAP; MPX-4_MAP
U3: LIS2DW12TR; LGA-12_2x2mm_P0.5mm; LCSC C189624
U4: LPS25HB; ST_HLGA-10_2.5x2.5mm_P0.6mm_LayoutBorder3x2y; LCSC C87898
U5: MCP6002-xSN; SOIC-8_3.9x4.9mm_P1.27mm; LCSC C7377
U6: L6205PD; SO20POWER; LCSC C36543
U7: TLS115_SOIC; PG-DSO-8-43
U8: TLS115_SON; HVSON-8-1EP_3x3mm_P0.65mm_EP1.6x2.4mm
VIN1, VIN2, VIN3, VIN4, VIN5, VIN6, VIN8: VIN8; PinHeader_1x01_P1.00mm_Vertical
VIN9: VIN9; PinHeader_1x01_P1.00mm_Vertical
VIN10: VIN10; PinHeader_1x01_P1.00mm_Vertical
VIN16: VIN16; PinHeader_1x01_P1.00mm_Vertical
VIN17: VIN17; PinHeader_1x01_P1.00mm_Vertical
VOUT2, VOUT3, VOUT4, VOUT7, VOUT8, VOUT9, VOUT10, VOUT11, VOUT12, VOUT13, VOUT14, VOUT15, VOUT16, VOUT17, VOUT18, VOUT19, VOUT20, VOUT21, VOUT22, VOUT23, VOUT24, VOUT25, VOUT26, VOUT27: VOUT4; PinHeader_1x01_P1.00mm_Vertical
VOUT5: VOUT5; PinHeader_1x01_P1.00mm_Vertical
VOUT6: VOUT6; PinHeader_1x01_P1.00mm_Vertical
cr1, cr2, cr3, cr4, cr6, cr7, cr8, cr10, cr11, cr12, cr13, cr14, cr15, cr16, cr17, cr18, cr19, cr20, cr21, cr22, cr23, cr24, cr25: cr; PinHeader_1x01_P1.00mm_Vertical

Connections:
12V_prot: C22.2, M9.W5 (V12P), RN7.1 (R1.1), RN7.2 (R2.1), RN7.3 (R3.1), RN7.4 (R4.1), RN8.1 (R1.1), RN8.2 (R2.1), RN8.3 (R3.1), RN8.4 (R4.1), U7.7 (EN), U7.8 (IN), U8.7 (EN), U8.8 (IN), VOUT6.1
+3V3: C4.1, C5.2, D6.2 (A), J4.3, M11.N16 (V33), M13.V1 (V33), SW1.2, TP3.1, U3.9 (Vdd), U3.10 (Vdd_IO), U4.1 (VDDio), U4.6 (~CS), U4.10 (VDD)
+5V: C6.1, D5.2 (A), J4.4, M1.E1 (V5), M2.V1 (V5), M3.W1 (V5_IN), M4.V1 (V5), M5.V2 (V5), M6.N1 (V5), M7.E2 (V5), M9.W14 (V5), M11.S1 (V5), R42.1, TP2.1, U5.8 (V+), U7.5 (ADJ), U8.5 (ADJ)
+5VA: C1.1, C2.1, M7.E5 (V5A), M7.J1 (PULL_V5A), M7.J7 (PULL_AUX4), M7.J17 (PULL_CAM), M7.J18 (PULL_VSS), M7.J21 (PULL_CRANK), M7.N1 (V5A), M8.E1 (V5A), M11.S33 (V5A), M12.E1 (V5A), R27.2, R34.2, U1.2 (Vcc), U2.3 (VCC)
+5VP: C23.2, J20.1, J20.2, J21.1, JP59.2, U7.1 (OUT), U8.1 (OUT)
+12V: D2.1 (K), D4.2 (A), M1.V1 (V12), M5.V1 (V12), TP1.1
+12V_RAW: C9.1, C11.1, C13.1, C14.1, C15.1, C16.1, C17.1, C18.1, C19.1, C20.1, C21.1, D1.1 (K), D3.1 (K), D8.1 (K), D10.1 (K), D12.2 (A), D32.2 (A), D44.1 (K), J4.5, JP54.2, JP56.2, M1.E2 (V12_RAW), M9.S11 (V12_RAW), R15.1, U6.2 (VSA), U6.19 (VSB)
+ETB: M11.E14 (OUT_PWM2), U6.7 (IN2A), U6.15 (IN2B)
-ETB: M11.E15 (OUT_PWM3), U6.6 (IN1A), U6.14 (IN1B)
A1: M7.N4 (O2S2), M11.S30 (IN_O2S2)
A2: M7.N12 (MAP3), M11.S22 (IN_MAP3)
A4: M7.N11 (RES3), M11.S23 (IN_RES3)
AC_COMPR: M9.W34 (LOW4_DUAL), M11.E21 (OUT_IO7)
AFR: M7.N18 (O2S), M11.S16 (IN_O2S)
AUX4: M7.N7 (AUX4), M11.S27 (IN_AUX4)
BOOT0: M11.N28 (BOOT0), SW1.1
CAM: M7.N19 (CAM), M11.S15 (IN_CAM)
CAN+: JP86.2, M2.S2 (CANH), M4.S2 (CANH)
CAN-: JP85.2, M2.S1 (CANL), M4.S1 (CANL)
CAN_RX: M2.V6 (CAN_RX), M11.N2 (CAN_RX)
CAN_TX: M2.V5 (CAN_TX), M11.N3 (CAN_TX)
CAN_VIO: M2.V2 (CAN_VIO), M11.N1 (CAN_VIO)
CLT: M7.N16 (CLT), M11.S18 (IN_CLT)
COIL_1: F6.2, Q1.2 (C), R7.1
COIL_2: F7.2, Q3.2 (C), R9.1
COIL_3: F8.2, Q5.2 (C), R12.2
COIL_4: F2.2, Q2.2 (C), R8.1
COIL_5: F4.2, Q6.2 (C), R11.2
COIL_6: F3.2, Q4.2 (C), R13.2
COIL_7: F1.2, Q7.2 (C), R10.1
COIL_8: F5.2, Q8.2 (C), R14.2
CRANK: M7.N21 (CRANK), M11.S13 (IN_CRANK)
ETB_EN: M11.E27 (OUT_PWM1), R28.2, R29.2
EVAP: M9.W38 (LOW3_DUAL), M11.E7 (OUT_IO5)
FUEL_CONSUM: M9.W22 (PP2), M11.E18 (OUT_PWM6)
GND: BT1.2 (-), C1.2, C2.2, C3.2, C4.2, C5.1, C6.2, C9.2, C10.2, C11.2, C13.2, C14.2, C16.2, C17.2, C18.2, C19.2, C20.2, C21.2, C22.1, C23.1, J1.5 (GND), J2.5, J4.1, J4.2, J17.1, J17.2, J18.S, J20.5, J20.6, J21.4, JP15.2, M1.S1 (GND), M2.E1 (GND), M3.E6 (LSU_H-), M3.G (GND), M4.E1 (GND), M5.G (GND), M6.G (GND), M7.E1 (GND), M7.J2 (PULL_GNDA), M7.J3 (PULL_RES2), M7.J4 (PULL_O2S2), M7.J5 (PULL_PPS), M7.J6 (PULL_RES1), M7.J11 (PULL_RES3), M7.J12 (PULL_MAP3), M7.J13 (PULL_MAP2), M7.J14 (PULL_MAP1), M7.J19 (PULL_TPS), M7.J20 (PULL_O2S), M7.J22 (PULL_KNOCK), M7.J23 (PULL_SENS4), M7.J25 (PULL_SENS2), M7.J26 (PULL_SENS1), M7.N2 (GNDA), M8.E2 (GND), M9.G (GND), M9.S3 (GND), M10.G (GND), M11.S2 (GND), M11.S32 (GNDA), M12.E2 (GND), M13.G (GND), M13.V2 (GND), M13.V3 (GND), P1.1, PP1.6, PP1.28, PP1.34, PP1.39, PP1.40, PP1.44, PP1.45, PP1.55, PP1.71, PP1.84, Q1.3 (E), Q2.3 (E), Q3.3 (E), Q4.3 (E), Q5.3 (E), Q6.3 (E), Q7.3 (E), Q8.3 (E), Q9.3 (S), Q10.3 (S), R1.1, R2.1, R3.2, R4.1, R16.1, R25.1, R26.1, R29.1, R31.2, R32.2, R33.2, R35.1, R43.2, RN5.1 (R1.1), RN5.2 (R2.1), RN5.3 (R3.1), RN5.4 (R4.1), RN6.1 (R1.1), RN6.2 (R2.1), RN6.3 (R3.1), RN6.4 (R4.1), SW2.2, TP4.1, U1.3 (GND), U2.2 (GND), U3.6 (GND), U3.7 (RES), U3.8 (GND), U4.3 (GND), U4.5 (SA0/MISO), U4.8 (GND), U4.9 (GND), U5.4 (V-), U6.1 (GND@1), U6.8 (SENSEA), U6.10 (GND@2), U6.11 (GND@3), U6.13 (SENSEB), U6.20 (GND@4), U6.SLUG1 (SLUG@1), U6.SLUG2 (SLUG@2), U6.SLUG3 (SLUG@3), U7.3 (GND), U7.9 (GND), U8.3 (GND), U8.9 (GND)
HV_1: F6.1, PP1.50
HV_2: F7.1, PP1.51
HV_3: F8.1, PP1.52
HV_4: F2.1, PP1.23
HV_5: F4.1, PP1.25
HV_6: F3.1, PP1.24
HV_7: F1.1, PP1.22
HV_8: F5.1, PP1.49
IAT: M7.N15 (IAT), M11.S19 (IN_IAT)
ICV: M11.E28 (OUT_PWM8), Q10.1 (IN), R1.2
IDLE: M11.E17 (OUT_PWM5), Q9.1 (IN), R2.2
IGN1: M10.V8 (IGN1), M11.W1 (OUT_IGN1)
IGN2: M10.V7 (IGN2), M11.W2 (OUT_IGN2)
IGN3: M10.V6 (IGN3), M11.W3 (OUT_IGN3)
IGN4: M10.V5 (IGN4), M11.W4 (OUT_IGN4)
IGN5: M10.V4 (IGN5), M11.W5 (OUT_IGN5)
IGN6: M10.V3 (IGN6), M11.W6 (OUT_IGN6)
IGN7: M10.V2 (IGN7), M11.W7 (OUT_IGN7)
IGN8: M10.V1 (IGN8), M11.W8 (OUT_IGN8)
IGN_V5: M10.V9 (VCC), M11.W9 (IGN_V5)
IGN_V33: M10.V10 (V33), M11.W10 (IGN_V33)
INJ1: M9.W24 (INJ1), M11.E25 (OUT_INJ1)
INJ2: M9.W23 (INJ2), M11.E26 (OUT_INJ2)
INJ3: M9.W20 (INJ3), M11.E29 (OUT_INJ3)
INJ4: M9.W19 (INJ4), M11.E30 (OUT_INJ4)
INJ5: M9.W18 (INJ5), M11.E31 (OUT_INJ5)
INJ6: M9.W17 (INJ6), M11.E32 (OUT_INJ6)
INJ7: M9.W16 (INJ7), M11.E33 (OUT_INJ7)
INJ8: M9.W15 (INJ8), M11.E34 (OUT_INJ8)
INK1: M7.N22 (KNOCK), M11.S12 (IN_KNOCK)
INK2: M7.N24 (SENS3), M11.S10 (IN_SENS3)
IN_CAM: JP17.2, M7.S5 (IN_CAM)
IN_CLT: JP78.2, M7.S15 (IN_CLT), R34.1
IN_CRANK: D7.1 (K), D42.2 (A), M6.W2 (OUT_VR1), M7.S8 (IN_CRANK), R5.2
IN_CRANK+: JP43.2, M6.E2 (IN_VR1+), R5.1
IN_CRANK-: JP16.2, M6.E1 (IN_VR1-), R6.1
IN_IAT: JP77.2, M7.S16 (IN_IAT), R27.1
IN_KNOCK1: M7.S7 (IN_KNOCK), M8.E3 (OUT_KNOCK), U5.3 (+)
IN_KNOCK1_RAW: JP69.2, M8.W1 (IN_KNOCK)
IN_KNOCK2: M7.S3 (IN_SENS3), M12.E3 (OUT_KNOCK), R26.2, U5.5 (+)
IN_KNOCK2_RAW: JP70.2, M12.W1 (IN_KNOCK)
IN_MAF: JP14.2, JP41.2, M7.S11 (IN_MAP1), R35.2
IN_MAP2: M7.S12 (IN_MAP2), U2.1 (VOUT)
IN_PPS1: J21.3, M7.S24 (IN_PPS)
IN_PPS2: J21.2, M7.S18 (IN_AUX2), R25.2
IN_TPS: JP73.2, M7.S10 (IN_TPS)
IN_TPS2: J20.4, M7.S17 (IN_AUX1), R4.2
IN_TPS3: J20.3, M7.S20 (IN_AUX3), R16.2
IN_VIGN: JP2.2, M1.V3 (IN_VIGN)
IN_VSS: JP42.2, M7.S6 (IN_VSS)
LPS_SCL: M11.N19 (I2C_SCL), U4.2 (SCL/SCLK)
LPS_SDA: M11.N18 (I2C_SDA), U4.4 (SDA/MOSI)
LSU_CALIBR_RES: J17.5, M3.E4 (LSU_Rtrim), P3.1
LSU_HEAT-: J17.3, J17.4, M3.E5 (LSU_H+), P2.1
LSU_PUMP_I: J17.6, M3.E3 (LSU_Ip), P4.1
LSU_SENSOR_U: J17.8, M3.E1 (LSU_Un), P6.1
LSU_SENSOR_U/PUMP_I: J17.7, M3.E2 (LSU_Vm), P5.1
MAF: M7.N14 (MAP1), M11.S20 (IN_MAP1)
MAIN_RELAY: M9.W40 (LOW5_MAIN), M11.E8 (OUT_IO1)
MAP2: M7.N13 (MAP2), M11.S21 (IN_MAP2)
NRESET: C3.1, M11.N24 (nReset), SW2.1
unnamed: BT1.1 (+), D9.2 (A)
unnamed: C7.1, U5.1, U5.2 (-)
unnamed: C7.2, J18.T
unnamed: C8.1, U5.6 (-), U5.7
unnamed: C8.2, J18.R
unnamed: C10.1, R28.1, U6.5 (ENA), U6.16 (ENB)
unnamed: C12.1, R30.1
unnamed: C12.2, U6.4 (VCP)
unnamed: C15.2, D33.1 (K), U6.17 (VBOOT)
unnamed: D1.2 (A), D12.1 (K), R32.1
unnamed: D2.2 (A), D4.1 (K), R33.1
unnamed: D3.2 (A), JP6.2
unnamed: D5.1 (K), R31.1
unnamed: D6.1 (K), R3.1
unnamed: D11.1 (K), D43.2 (A), R43.1
unnamed: D13.1 (K), D24.2 (A), RN7.5 (R4.2)
unnamed: D14.1 (K), D28.2 (A), RN7.6 (R3.2)
unnamed: D15.2 (A), D40.1 (K), R15.2
unnamed: D16.1 (K), RN5.5 (R4.2)
unnamed: D17.1 (K), RN5.7 (R2.2)
unnamed: D18.1 (K), RN6.5 (R4.2)
unnamed: D19.1 (K), RN6.7 (R2.2)
unnamed: D20.1 (K), RN5.6 (R3.2)
unnamed: D21.1 (K), RN5.8 (R1.2)
unnamed: D22.1 (K), RN6.6 (R3.2)
unnamed: D23.1 (K), RN6.8 (R1.2)
unnamed: D25.2 (A), D34.1 (K), RN7.7 (R2.2)
unnamed: D26.2 (A), D36.1 (K), RN8.5 (R4.2)
unnamed: D27.2 (A), D38.1 (K), RN8.7 (R2.2)
unnamed: D29.2 (A), D35.1 (K), RN7.8 (R1.2)
unnamed: D30.2 (A), D37.1 (K), RN8.6 (R3.2)
unnamed: D31.2 (A), D39.1 (K), RN8.8 (R1.2)
unnamed: D32.1 (K), D33.2 (A), R30.2
unnamed: D7.2 (A), D42.1 (K), R42.2
unnamed: G3.1, G3.6, G3.11
unnamed: G3.5, G3.10, G3.15
unnamed: G3.2, G3.7, G3.12
unnamed: G3.3, G3.8, G3.13
unnamed: G3.4, G3.9, G3.14
unnamed: G4.1, G4.6, G4.11
unnamed: G4.5, G4.10, G4.15
unnamed: G4.2, G4.7, G4.12
unnamed: G4.3, G4.8, G4.13
unnamed: G4.4, G4.9, G4.14
unnamed: G6.1, G6.6, G6.11
unnamed: G6.5, G6.10, G6.15
unnamed: G6.2, G6.7, G6.12
unnamed: G6.3, G6.8, G6.13
unnamed: G6.4, G6.9, G6.14
unnamed: G7.1, G7.6, G7.11
unnamed: G7.5, G7.10, G7.15
unnamed: G7.2, G7.7, G7.12
unnamed: G7.3, G7.8, G7.13
unnamed: G7.4, G7.9, G7.14
unnamed: J14.1, M6.E3 (IN_VR2+)
unnamed: J15.1, M6.E4 (IN_VR2-)
unnamed: J16.1, M6.W1 (OUT_VR2)
unnamed: JP1.1, PP1.1
unnamed: JP2.1, JP56.1, PP1.56
unnamed: JP3.1, PP1.3
unnamed: JP4.1, PP1.4
unnamed: JP5.1, PP1.5
unnamed: JP7.1, PP1.7
unnamed: JP8.1, PP1.8
unnamed: JP14.1, PP1.14
unnamed: JP15.1, PP1.15
unnamed: JP16.1, PP1.16
unnamed: JP17.1, PP1.17
unnamed: JP20.1, PP1.20
unnamed: JP21.1, PP1.21
unnamed: JP26.1, PP1.26
unnamed: JP27.1, PP1.27
unnamed: JP29.1, PP1.29
unnamed: JP31.1, PP1.31
unnamed: JP32.1, PP1.32
unnamed: JP33.1, PP1.33
unnamed: JP35.1, PP1.35
unnamed: JP36.1, PP1.36
unnamed: JP41.1, PP1.41
unnamed: JP42.1, PP1.42
unnamed: JP43.1, PP1.43
unnamed: JP46.1, PP1.46
unnamed: JP47.1, PP1.47
unnamed: JP48.1, PP1.48
unnamed: JP54.1, PP1.54
unnamed: JP59.1, PP1.59
unnamed: JP69.1, PP1.69
unnamed: JP70.1, PP1.70
unnamed: JP73.1, PP1.73
unnamed: JP77.1, PP1.77
unnamed: JP78.1, PP1.78
unnamed: JP85.1, PP1.85
unnamed: JP86.1, PP1.86
unnamed: M3.J1 (SEL1), M3.J_GND1 (PULL_DOWN1)
unnamed: M3.W2 (CAN_VIO), M4.V2 (CAN_VIO)
unnamed: M3.W3 (CAN_RX), M4.V6 (CAN_RX)
unnamed: M3.W4 (CAN_TX), M4.V5 (CAN_TX)
unnamed: M7.E3 (WBO_O2S2), VIN17.1
unnamed: M7.E4 (WBO_O2S), VIN16.1
unnamed: M7.S1 (IN_SENS1), VIN8.1
unnamed: M7.S2 (IN_SENS2), VIN9.1
unnamed: M7.S4 (IN_SENS4), VIN10.1
unnamed: M7.S9 (IN_O2S), VIN5.1
unnamed: M7.S19 (IN_MAP3), U1.4 (Vout)
unnamed: M7.S21 (IN_AUX4), VIN1.1
unnamed: M7.S22 (IN_RES3), VIN4.1
unnamed: M7.S23 (IN_RES1), VIN2.1
unnamed: M7.S25 (IN_O2S2), VIN6.1
unnamed: M7.S26 (IN_RES2), VIN3.1
unnamed: M9.S1 (OUT_SOLENOID_A1), VOUT22.1
unnamed: M9.S2 (OUT_SOLENOID_A2), VOUT23.1
unnamed: M9.S4 (OUT_SOLENOID_B1), VOUT14.1
unnamed: M9.S5 (OUT_SOLENOID_B2), VOUT15.1
unnamed: M9.S9 (OUT_HIGH2), VOUT5.1
unnamed: M9.S10 (OUT_LOW11), VOUT10.1
unnamed: M9.S12 (OUT_LOW8_PULLUP), VOUT8.1
unnamed: M9.S13 (OUT_LOW12), VOUT11.1
unnamed: M9.S14 (OUT_LOW9), VOUT9.1
unnamed: M9.W1 (OUT_LOW2), VOUT2.1
unnamed: M9.W3 (OUT_LOW6_DIODE), VOUT3.1
unnamed: M9.W8 (OUT_HIGH1), VOUT4.1
unnamed: M9.W9 (OUT_LOW7_PULLUP), VOUT7.1
unnamed: M9.W21 (LOW1), VOUT24.1
unnamed: M9.W25 (LOW6_DIODE), VOUT26.1
unnamed: M9.W27 (LOW9), VOUT13.1
unnamed: M9.W29 (LOW2), VOUT25.1
unnamed: M9.W30 (SOLENOID_B2), VOUT21.1
unnamed: M9.W31 (SOLENOID_B1), VOUT20.1
unnamed: M9.W32 (SOLENOID_A2), VOUT19.1
unnamed: M9.W33 (SOLENOID_A1), VOUT18.1
unnamed: M9.W35 (LOW11), VOUT16.1
unnamed: M9.W36 (LOW12), VOUT17.1
unnamed: M9.W37 (LOW8_HIGH2), VOUT12.1
unnamed: M9.W39 (LOW7_HIGH1), VOUT27.1
unnamed: M11.E1 (SPI1_SCK), MMCU9.1
unnamed: M11.E2 (SPI1_MISO), MMCU10.1
unnamed: M11.E3 (SPI1_MOSI), MMCU11.1
unnamed: M11.E4 (SPI1_CS1), MMCU12.1
unnamed: M11.E5 (SPI1_CS2), MMCU13.1
unnamed: M11.E9 (OUT_IO6), MMCU28.1
unnamed: M11.E10 (OUT_IO10), MMCU18.1
unnamed: M11.E11 (OUT_IO9), MMCU30.1
unnamed: M11.E12 (OUT_IO2), MMCU15.1
unnamed: M11.E13 (OUT_IO12), MMCU31.1
unnamed: M11.E16 (OUT_PWM4), MMCU14.1
unnamed: M11.E20 (OUT_IO11), MMCU40.1
unnamed: M11.E22 (OUT_IO8), MMCU29.1
unnamed: M11.E23 (OUT_IO4), MMCU38.1
unnamed: M11.E24 (OUT_IO13), MMCU32.1
unnamed: M11.N4 (UART8_TX), MMCU2.1
unnamed: M11.N5 (UART8_RX), MMCU1.1
unnamed: M11.N6 (UART2_TX), MMCU4.1
unnamed: M11.N7 (UART2_RX), MMCU3.1
unnamed: M11.N12 (IO1), MMCU24.1
unnamed: M11.N13 (IO2), MMCU25.1
unnamed: M11.N14 (IO3), MMCU26.1
unnamed: M11.N15 (IO4), MMCU27.1
unnamed: M11.N25 (SWCLK), MMCU5.1
unnamed: M11.N26 (SWDIO), MMCU6.1
unnamed: M11.N27 (SWO), MMCU7.1
unnamed: M11.N32 (USB1ID), MMCU8.1
unnamed: M11.S3 (IN_D1), MMCU22.1
unnamed: M11.S4 (IN_D2), MMCU23.1
unnamed: M11.S5 (IN_D3), MMCU35.1
unnamed: M11.S6 (IN_D4), MMCU16.1
unnamed: PP1.11, cr1.1
unnamed: PP1.12, cr2.1
unnamed: PP1.13, cr3.1
unnamed: PP1.18, cr6.1
unnamed: PP1.19, cr7.1
unnamed: PP1.30, cr8.1
unnamed: PP1.37, cr10.1
unnamed: PP1.38, cr11.1
unnamed: PP1.60, cr12.1
unnamed: PP1.62, cr13.1
unnamed: PP1.64, cr14.1
unnamed: PP1.65, cr15.1
unnamed: PP1.66, cr16.1
unnamed: PP1.67, cr17.1
unnamed: PP1.68, cr18.1
unnamed: PP1.74, cr24.1
unnamed: PP1.76, cr25.1
unnamed: PP1.81, cr19.1
unnamed: PP1.82, cr20.1
unnamed: PP1.83, cr21.1
unnamed: PP1.87, cr22.1
unnamed: PP1.88, cr23.1
unnamed: Q1.1 (G), R17.1
unnamed: Q2.1 (G), R19.1
unnamed: Q3.1 (G), R21.1
unnamed: Q4.1 (G), R22.1
unnamed: Q5.1 (G), R20.1
unnamed: Q6.1 (G), R18.1
unnamed: Q7.1 (G), R23.1
unnamed: Q8.1 (G), R24.1
OUT_AC_COMPR: JP48.2, M9.W4 (OUT_LOW4_DUAL)
OUT_CHECK_ENGINE: JP8.2, M9.S8 (OUT_LOW1)
OUT_ETB+: J19.2, U6.3 (OUT2A), U6.18 (OUT2B)
OUT_ETB-: J19.1, U6.9 (OUT1A), U6.12 (OUT1B)
OUT_EVAP: D8.2 (A), JP36.2, M9.S7 (OUT_LOW3_DUAL)
OUT_FUEL_CONSUM: JP46.2, M9.S6 (OUT_PP2)
OUT_FUEL_PUMP_RELAY: D15.1 (K), D40.2 (A), JP1.2, M9.W2 (OUT_LOW10)
OUT_ICV: D44.2 (A), PP1.2, Q10.2 (D), cr4.1
OUT_IDLE: D10.2 (A), JP29.2, Q9.2 (D)
OUT_IGN1: D23.2 (A), M10.S8 (OUT_IGN1), R7.2, R17.2
OUT_IGN2: D19.2 (A), M10.S7 (OUT_IGN2), R9.2, R21.2
OUT_IGN3: D22.2 (A), M10.S6 (OUT_IGN3), R12.1, R20.2
OUT_IGN4: D18.2 (A), M10.S5 (OUT_IGN4), R8.2, R19.2
OUT_IGN5: D21.2 (A), M10.S4 (OUT_IGN5), R11.1, R18.2
OUT_IGN6: D17.2 (A), M10.S3 (OUT_IGN6), R13.1, R22.2
OUT_IGN7: D20.2 (A), M10.S2 (OUT_IGN7), R10.2, R23.2
OUT_IGN8: D16.2 (A), M10.S1 (OUT_IGN8), R14.1, R24.2
OUT_INJ1: D13.2 (A), D24.1 (K), JP33.2, M9.S18 (OUT_INJ1)
OUT_INJ2: D14.2 (A), D28.1 (K), JP32.2, M9.S16 (OUT_INJ2)
OUT_INJ3: D25.1 (K), D34.2 (A), JP31.2, M9.S17 (OUT_INJ3)
OUT_INJ4: D29.1 (K), D35.2 (A), JP5.2, M9.W7 (OUT_INJ4)
OUT_INJ5: D26.1 (K), D36.2 (A), JP3.2, M9.W10 (OUT_INJ5)
OUT_INJ6: D30.1 (K), D37.2 (A), JP4.2, M9.S15 (OUT_INJ6)
OUT_INJ7: D27.1 (K), D38.2 (A), JP6.1, JP7.2, M9.W12 (OUT_INJ7)
OUT_INJ8: D31.1 (K), D39.2 (A), JP35.2, M9.W11 (OUT_INJ8)
OUT_MAIN_RELAY: D11.2 (A), D43.1 (K), JP27.2, M9.W13 (OUT_LOW5_MAIN)
OUT_TACH: JP47.2, M9.W6 (OUT_PP1)
PPS1: M7.N5 (PPS), M11.S29 (IN_PPS)
PPS2: M7.N9 (AUX2), M11.S25 (IN_AUX2)
PUMP: M9.W26 (LOW10), M11.E6 (OUT_IO3)
RES1: M7.N6 (RES1), M11.S28 (IN_RES1)
RES2: M7.N3 (RES2), M11.S31 (IN_RES2)
SD_CLK: M11.N9 (SPI3_SCK), M13.V6 (SD_SCK)
SD_CS: M11.N8 (SPI3_CS), M13.V4 (SD_CS)
SD_MISO: M11.N10 (SPI3_MISO), M13.V7 (SD_MISO)
SD_MOSI: M11.N11 (SPI3_MOSI), M13.V5 (SD_MOSI)
SENS1: M7.N26 (SENS1), M11.S8 (IN_SENS1)
SENS2: M7.N25 (SENS2), M11.S9 (IN_SENS2)
SENS4: M7.N23 (SENS4), M11.S11 (IN_SENS4)
SPI_CS: M11.N23 (SPI2_CS), U3.2 (~CS)
SPI_MISO: M11.N21 (SPI2_MISO), U3.3 (SA0/SDO)
SPI_MOSI: M11.N22 (SPI2_MOSI), U3.4 (SDA/SDI)
SPI_SCK: M11.N20 (SPI2_SCK), U3.1 (SCL/SPC)
TACH: M9.W28 (PP1), M11.E19 (OUT_PWM7)
TPS: M7.N17 (TPS), M11.S17 (IN_TPS)
TPS2: M7.N10 (AUX1), M11.S24 (IN_AUX1)
TPS3: M7.N8 (AUX3), M11.S26 (IN_AUX3)
USBM: J1.2 (D-), J2.2, JP21.2, M11.N31 (USB1M)
USBP: J1.3 (D+), J2.3, JP20.2, M11.N30 (USB1P)
V12_PERM: JP26.2, M1.V4 (V12_PERM)
VBAT: D9.1 (K), M1.V2 (VBAT), M11.N17 (VBAT)
VBUS: J1.1 (VBUS), J2.1, M11.N29 (VBUS)
VIGN: M1.V5 (VIGN), M11.S7 (VIGN)
VREF1: M7.S14 (VREF1), R6.2
VREF2: M7.S13 (VREF2), M8.W2 (VREF), M12.W2 (VREF)
VSS: M7.N20 (VSS), M11.S14 (IN_VSS)

Notes on the sheet:
General purpose bus
Internal pullups
Baro
C540243
1 | Fuel pump 2 | ICV 3 | Inj 5 4 | Inj 6 5 | Inj 4 6 | GND 7 | VVT Solenoid | Inj7 8 | Check Engine Light 9 | X 10 | X 11 | NC 12 | NC 13 | NC 14 | GND | MAF gnd 15 | GND 16 | IN CRANK+ 17 | IN CAM 18 | NC 19 | NC 20 | USB_D+ 21 | USB_D- 22 | COIL 7 23 | COIL 4 24 | COIL 6 25 | COIL 5 26 | V12_PER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
SOIC-8
C540241
Ouputs
VVT_AV7
TSON-10
Injection
Accelerometer
Discrete inputs
Electronic Throttle Body/ETB
Ignition
Bus types
LEDs
Analog inputs (sensors)
C540242
ETB Drive-by-wire motor connector
C540240
Protected 5V analog power supply
