filipesbp/hellen88m42bmw/(commit log)

2025-03-13 update
    update
    [bom_replace_hellen88m42bmw-d.csv, bom_replace_xxxyyy-a.csv, hellen88m42bmw.kicad_sch]
2025-03-13 correction
    Error! The components used by Board_ID detection method (R133,R134) are undefined!
    Please include corresponding board definition file (board_id_XXX.csv) to your BOM replacement file.
    If your Board_ID is unknown (custom board), just add the following line to the end of your bom_replace file:
    #include hellen-one/board_id/board_id_unknown.csv
    ABORTING!
    Error: Process completed with exit code 3.
    [bom_replace_hellen88m42bmw-d.csv]
2025-03-13 [skip actions] Auto-generated board v2.1
    [hellen88m42bmw-B_Cu.gbl, hellen88m42bmw-B_Mask.gbs, hellen88m42bmw-B_Paste.gbp, hellen88m42bmw-B_Silkscreen.gbo, hellen88m42bmw-Edge_Cuts.gm1, hellen88m42bmw-F_Cu.gtl, hellen88m42bmw-F_Mask.gts, hellen88m42bmw-F_Paste.gtp]
2025-03-13 GHA says update kicad6-libraries
